tedyapo/sampling-scope-WIP/README.md

# sampling-scope-WIP
Work towards an open-source multi-GHz sampling oscilloscope design

Board designs are in Eagle. They are 4-layer, so require a subscription license to edit (I believe).

NB: as titled, this project is very much a work-in-progress. Completed designs will be published elsewhere.
