tedyapo/sampling-scope-WIP/proto2/README.md

# proto2

This version incorporates the timebase calibration loop.

It has not been fully tested yet.

This version will be abandoned, as it was never entended as a final product, just as a testbed for an evolving design.
