tedyapo/sampling-scope-WIP/timebase-cal-proto/README.md

# timebase-calibrator

This design is a simple test of the timebase calibration loop.

It does not function as an oscilloscope, simply serving to test calibration strategies for the SY89296U-based timebase.
