tedyapo/sampling-scope-WIP/(threads)

Thread 1 (2019-12-12):

pdf schemetic output of proto 2 is not readable

odinthenerd, 2019-12-12:
https://github.com/tedyapo/sampling-scope-WIP/blob/master/proto2/proto2-schematic.pdf this looks like the pdf printer was not called with the right params

tedyapo, 2019-12-13:
good catch; thanks; updated

Closed 2019-12-13.
