tedyapo/sampling-scope-WIP/proto2/proto2-schematic.pdf

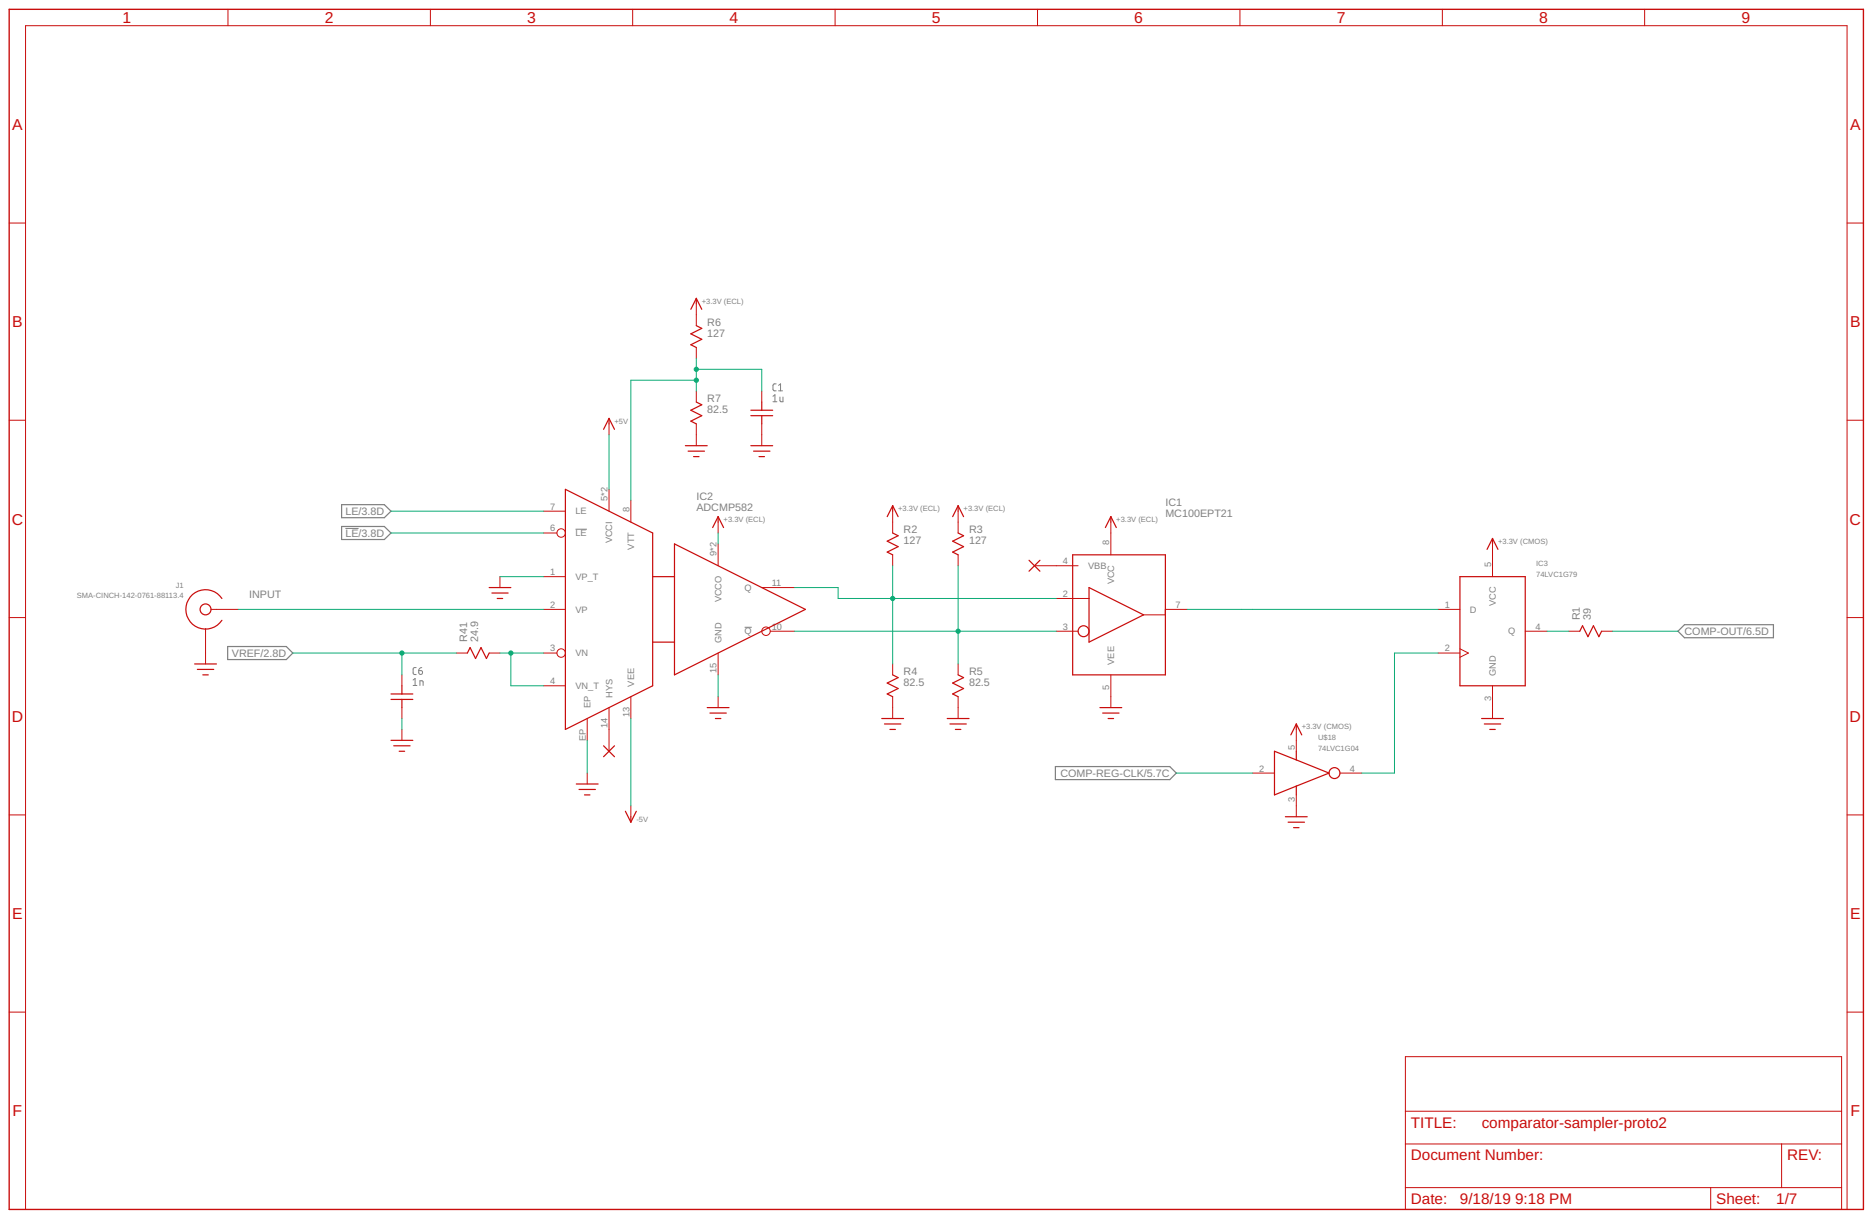
[picture p1: page 1]

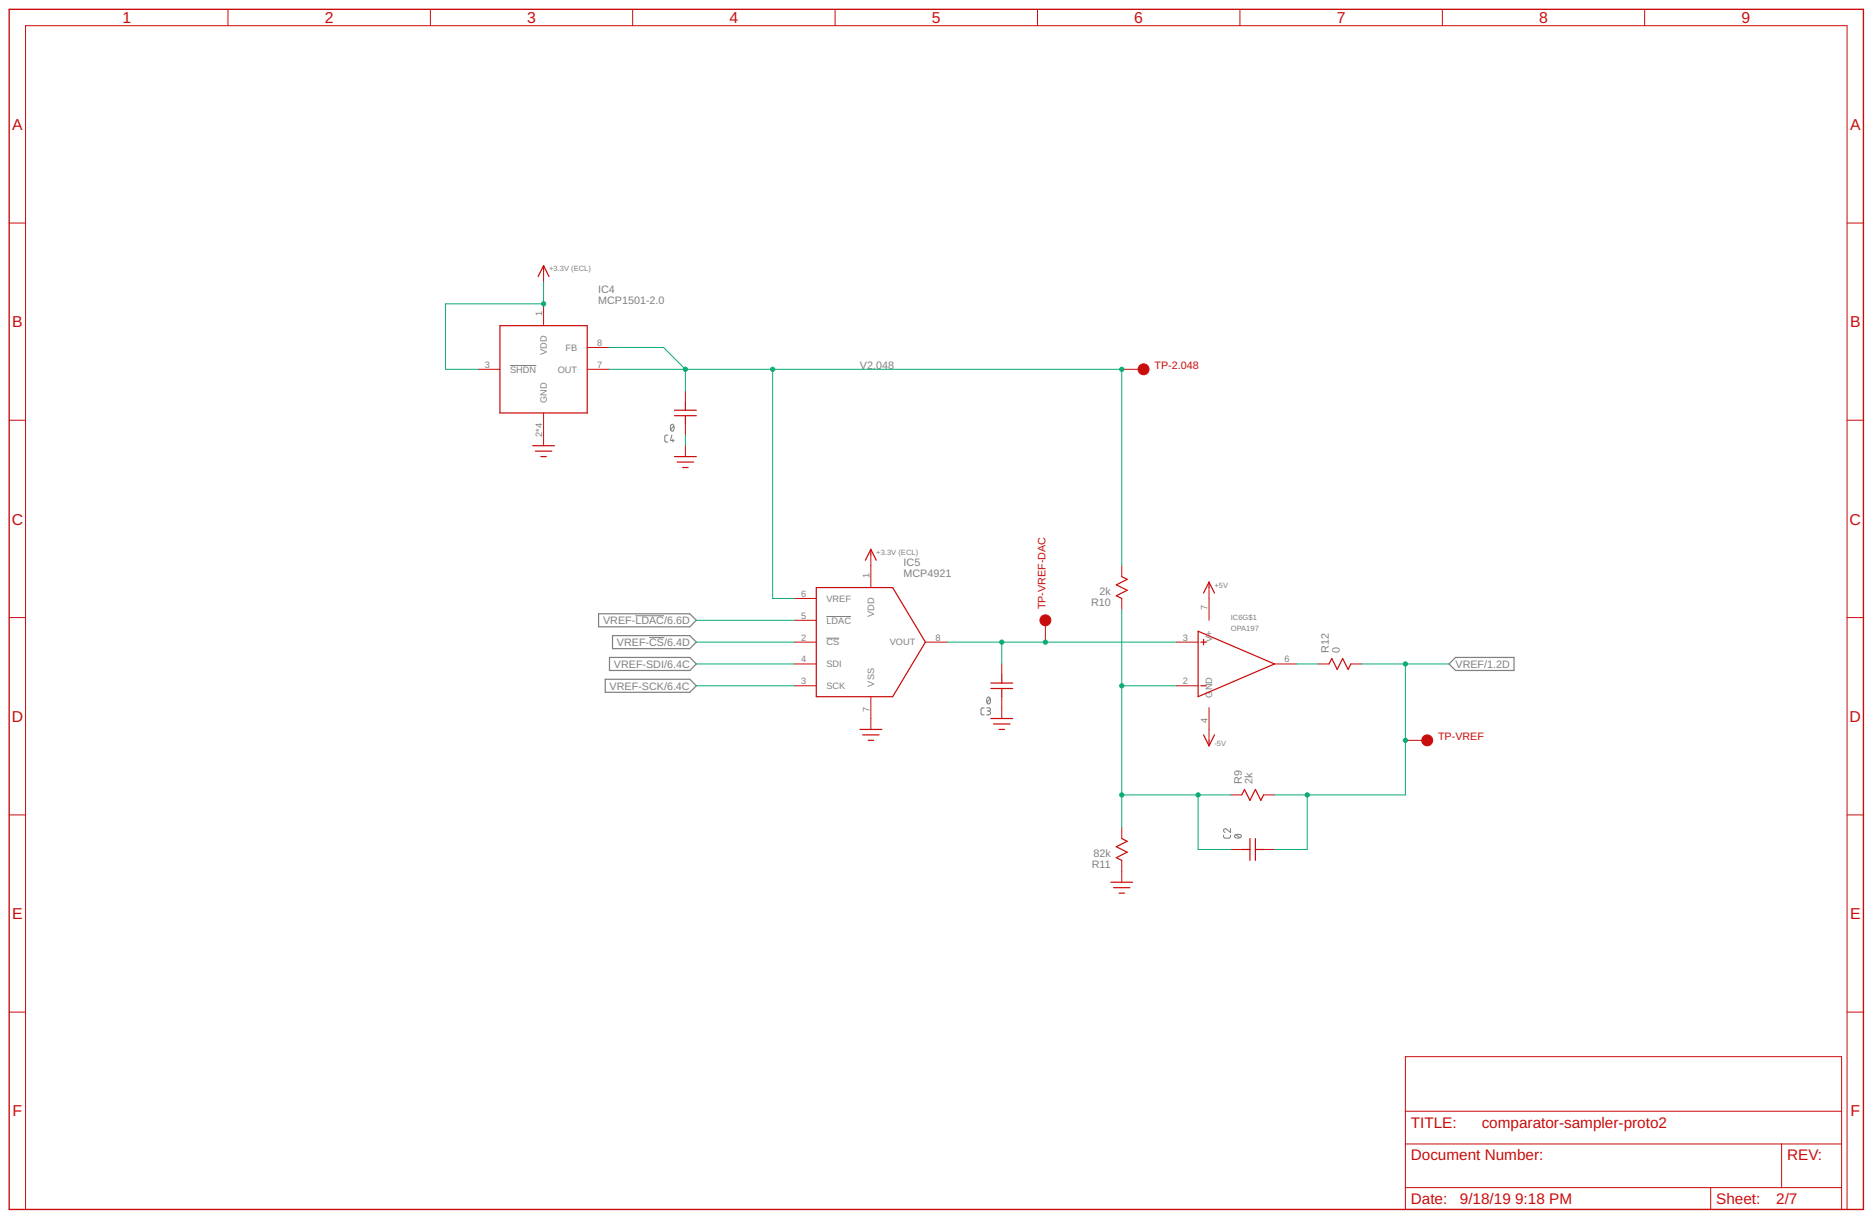
[picture p2: page 2]

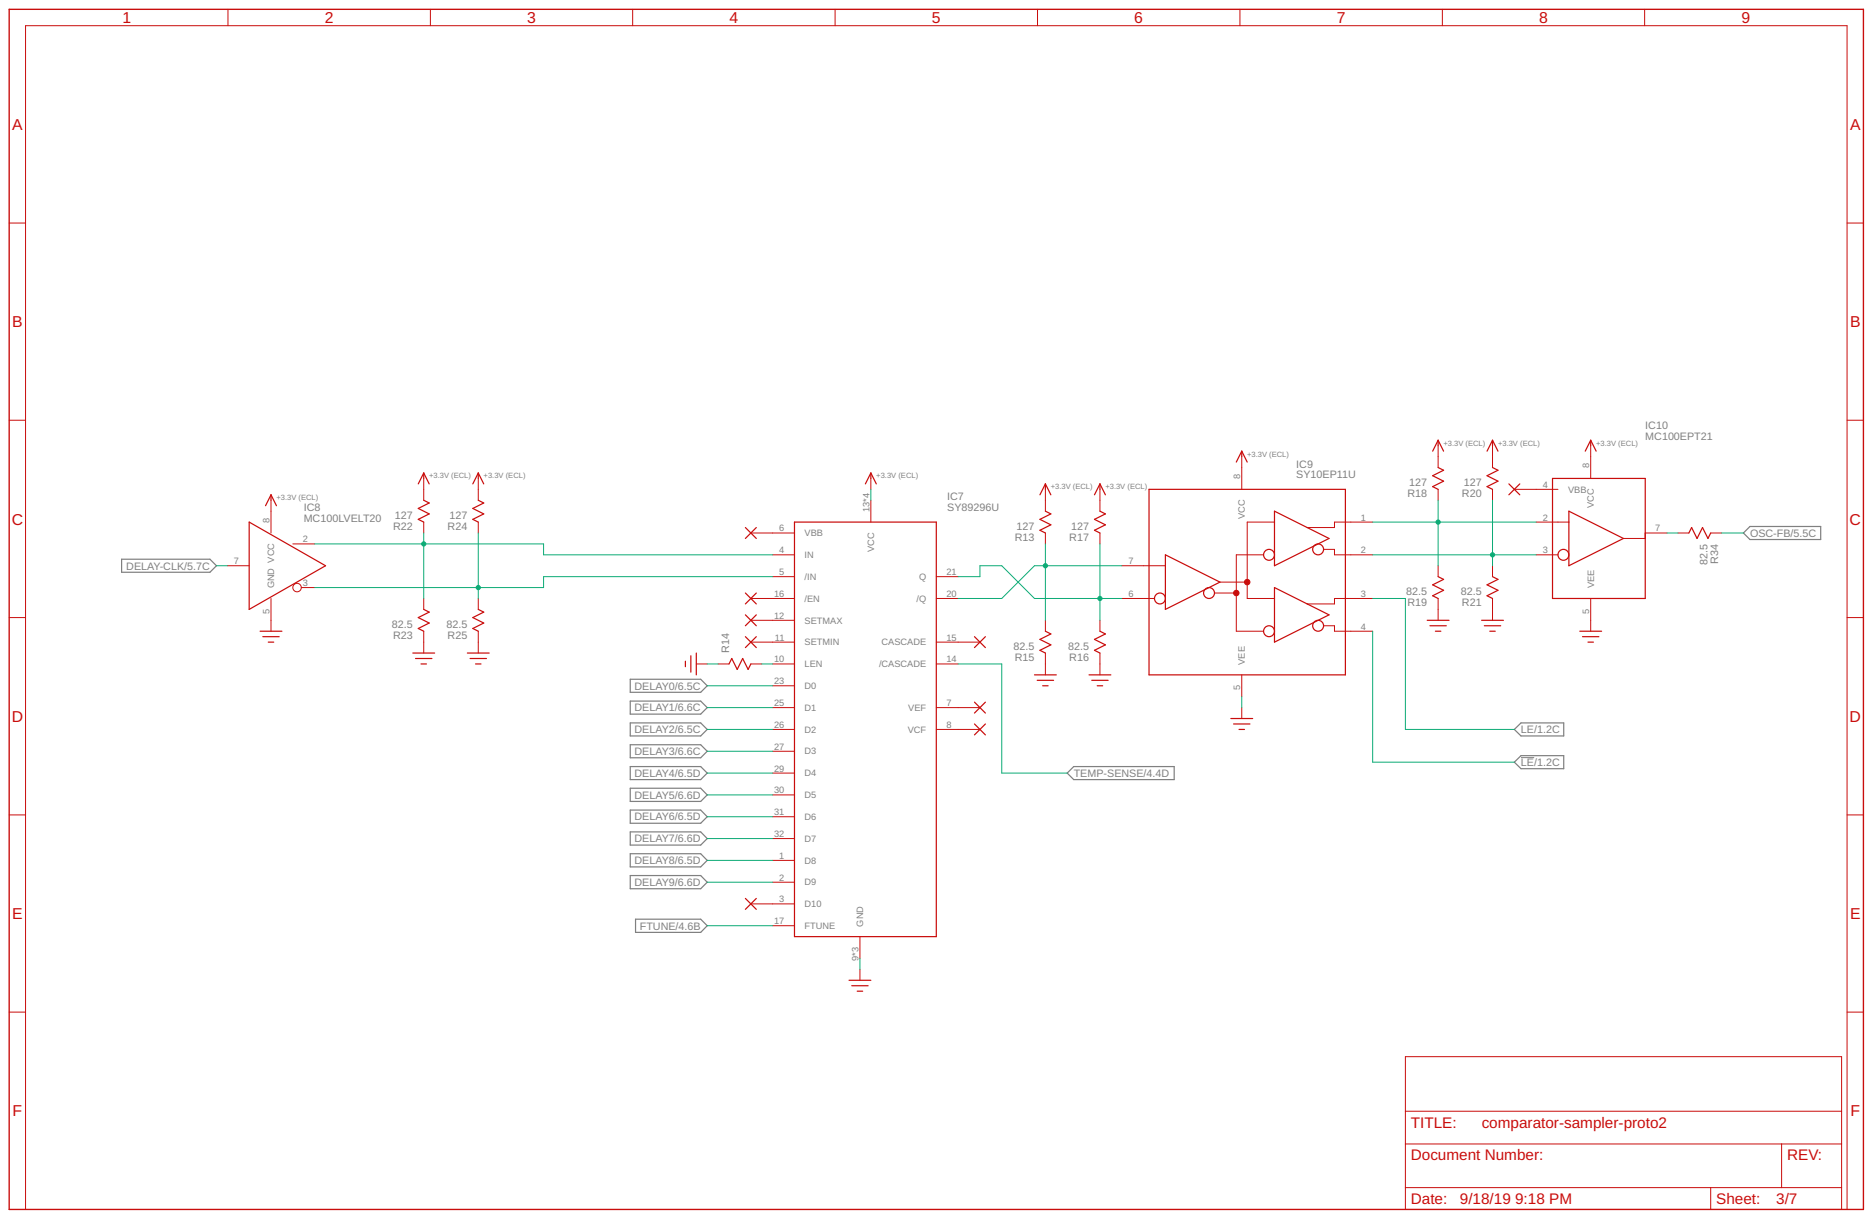
[picture p3: page 3]

7 VCC

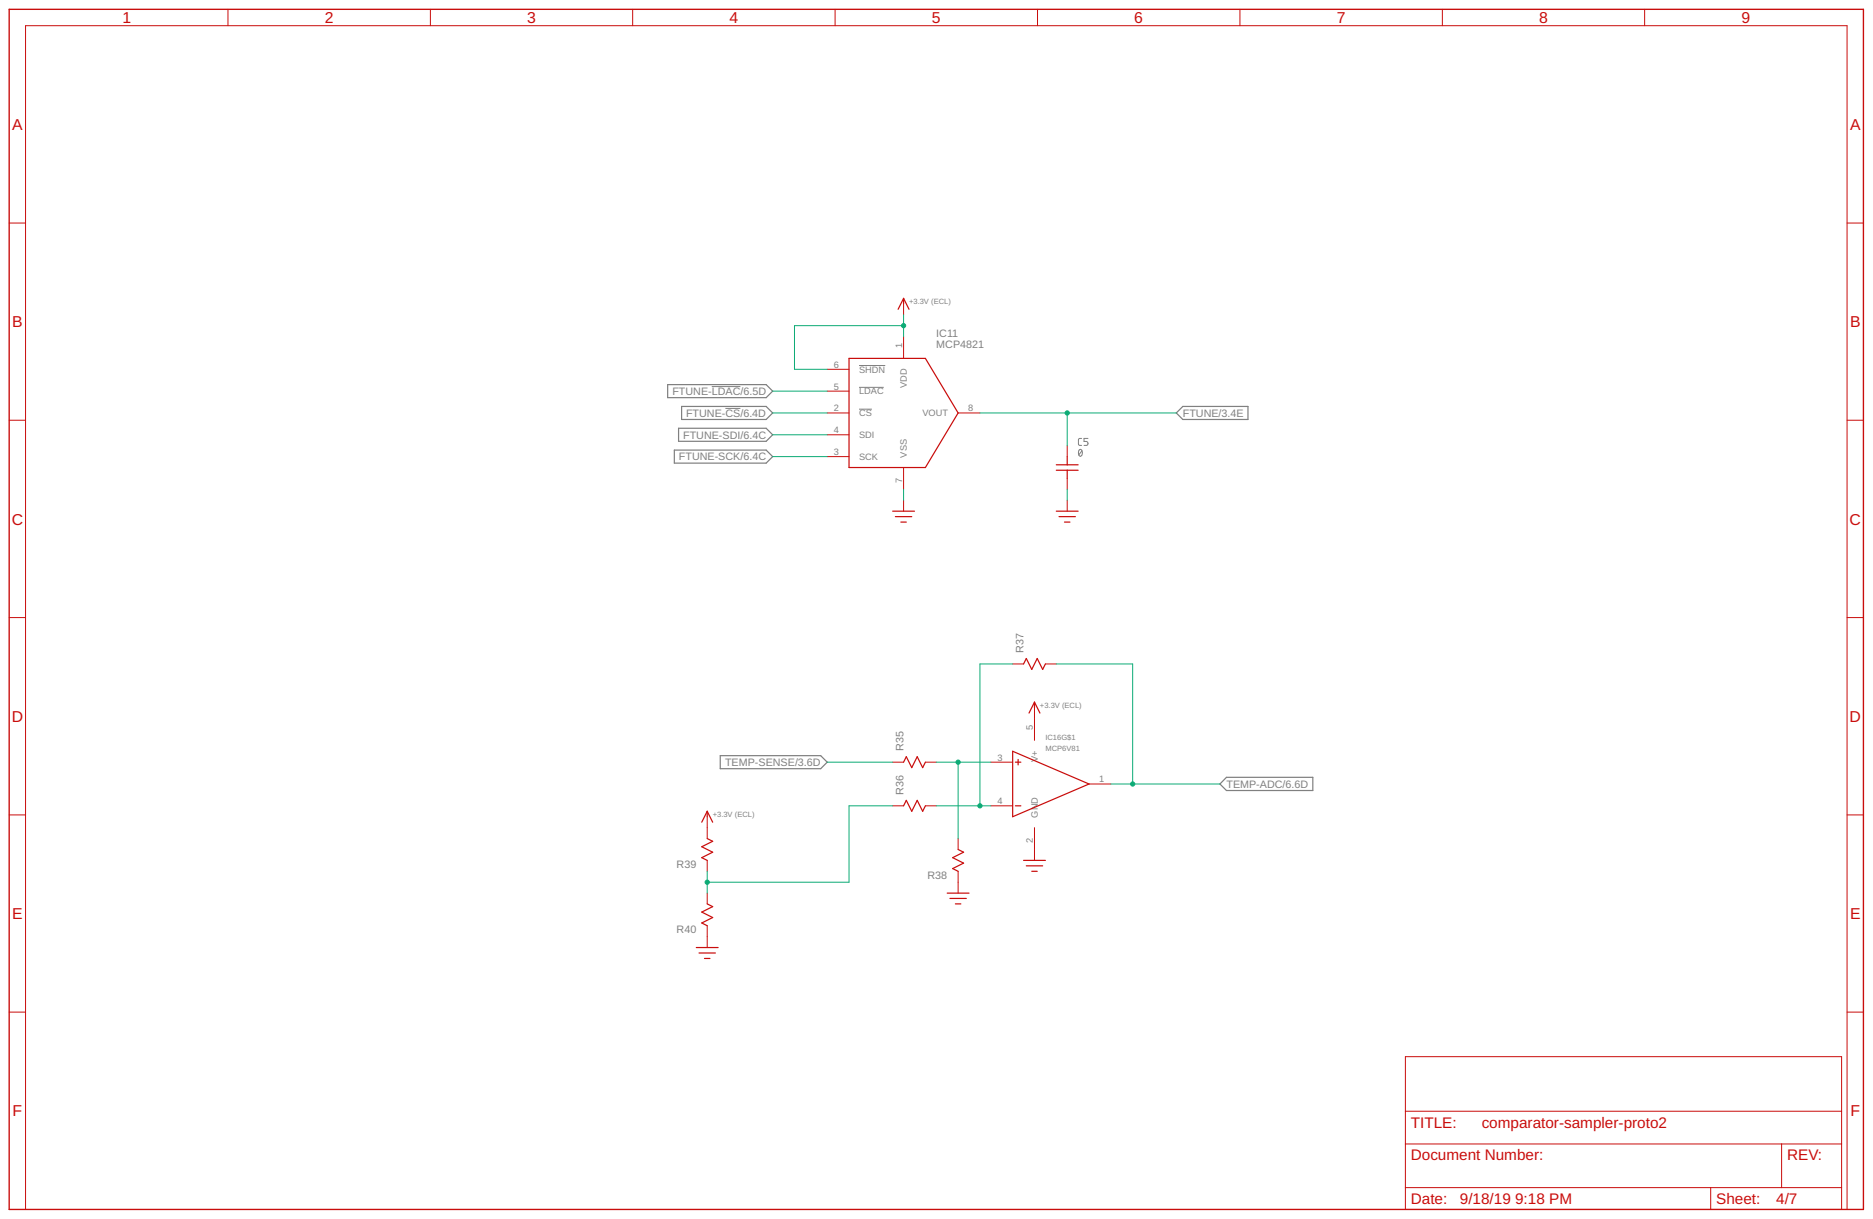
[picture p4: page 4]

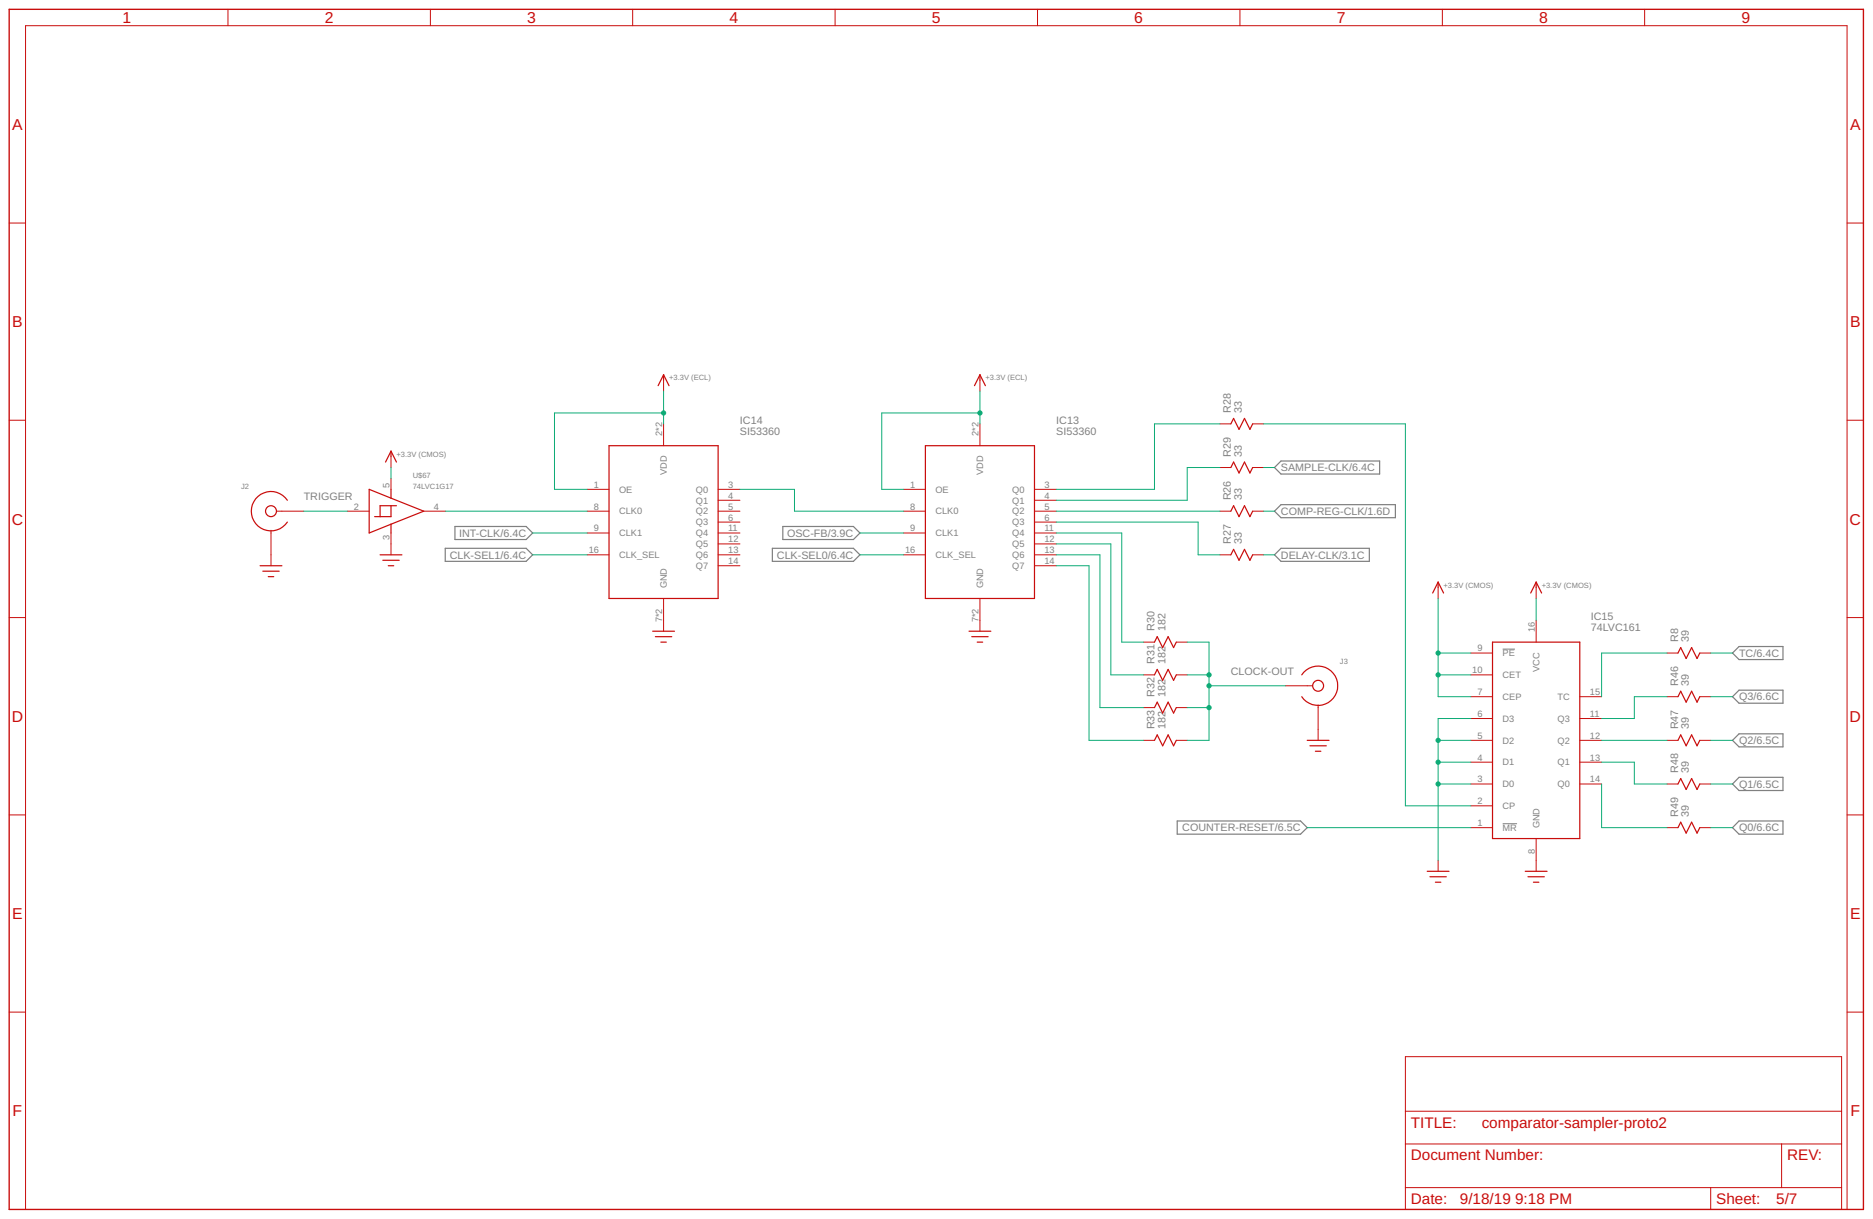
[picture p5: page 5]

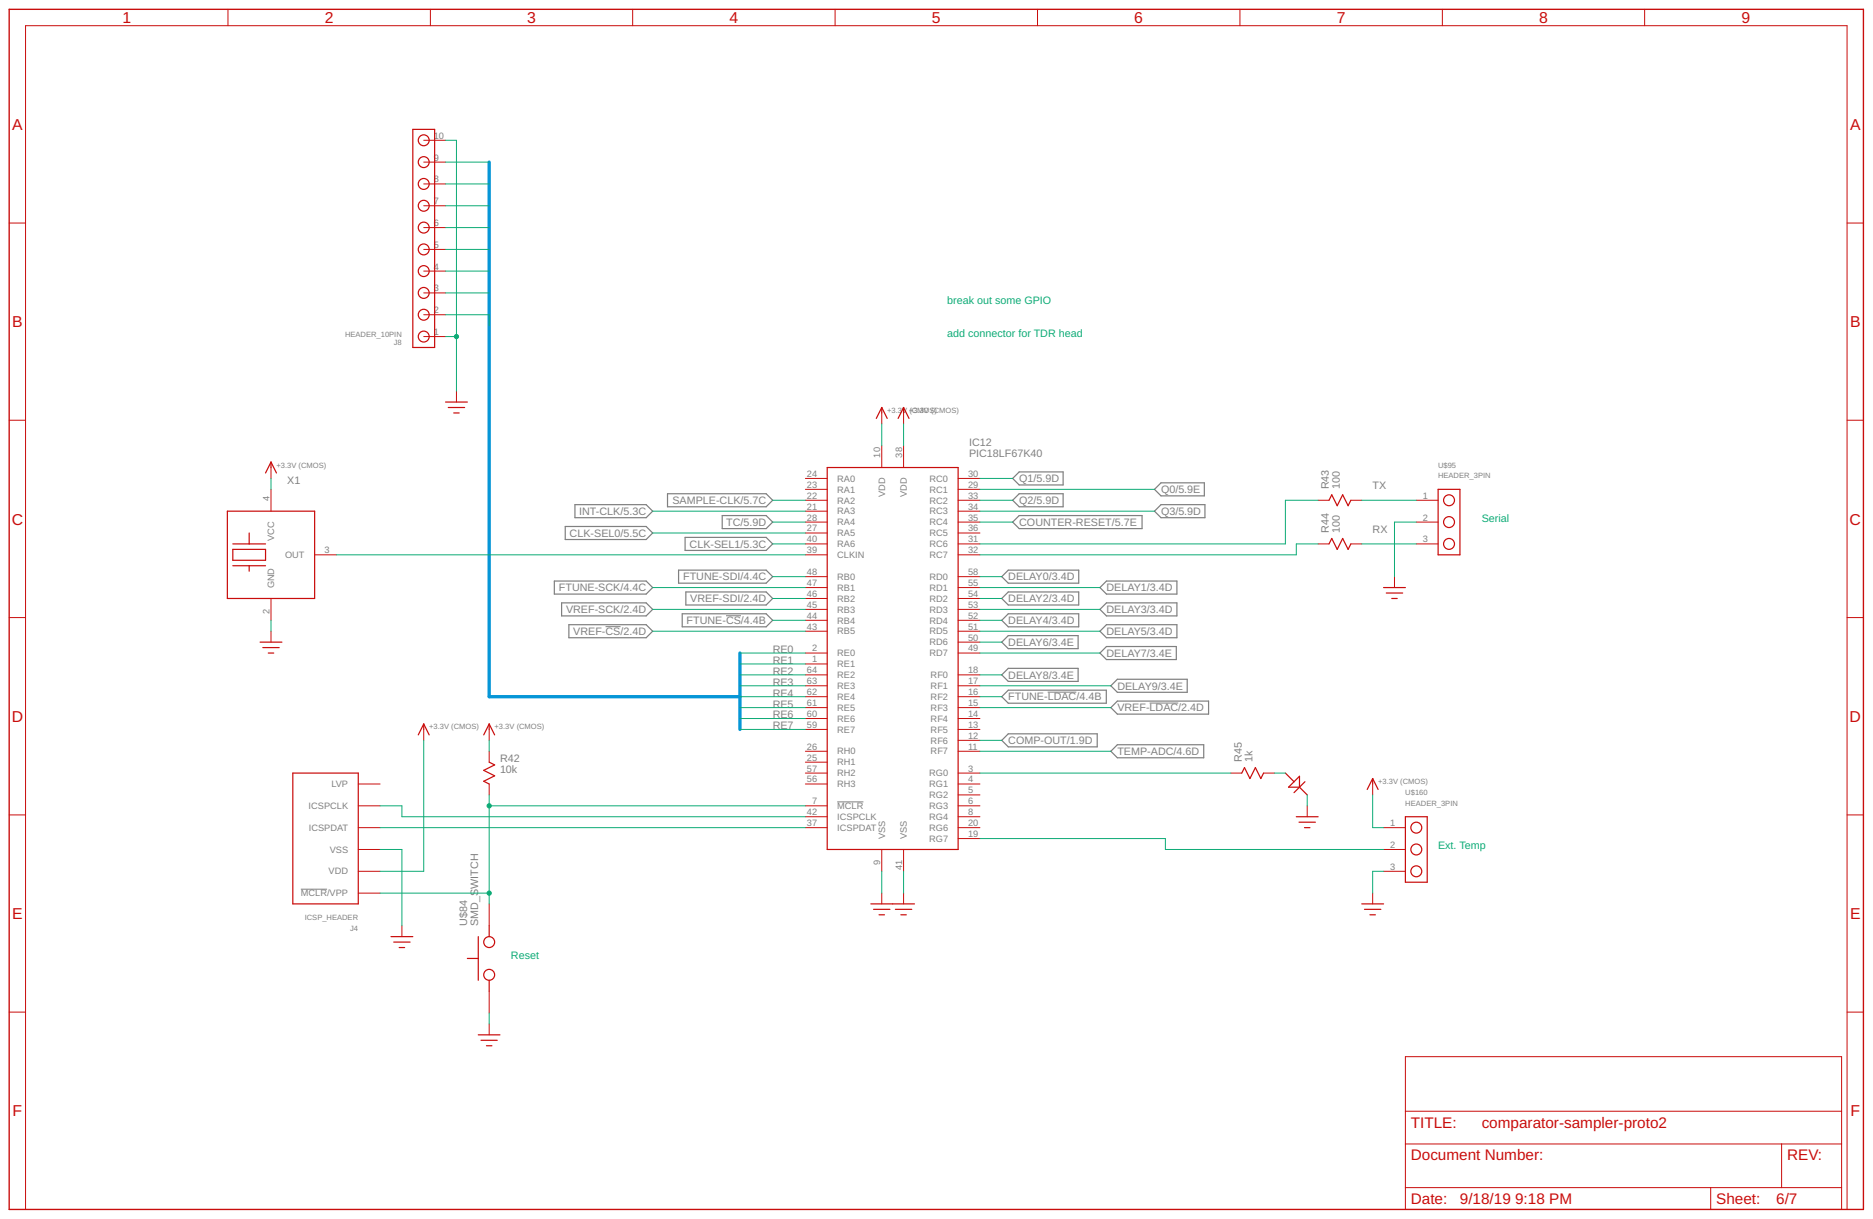
[picture p6: page 6]

break out some GPIO

add connector for TDR head

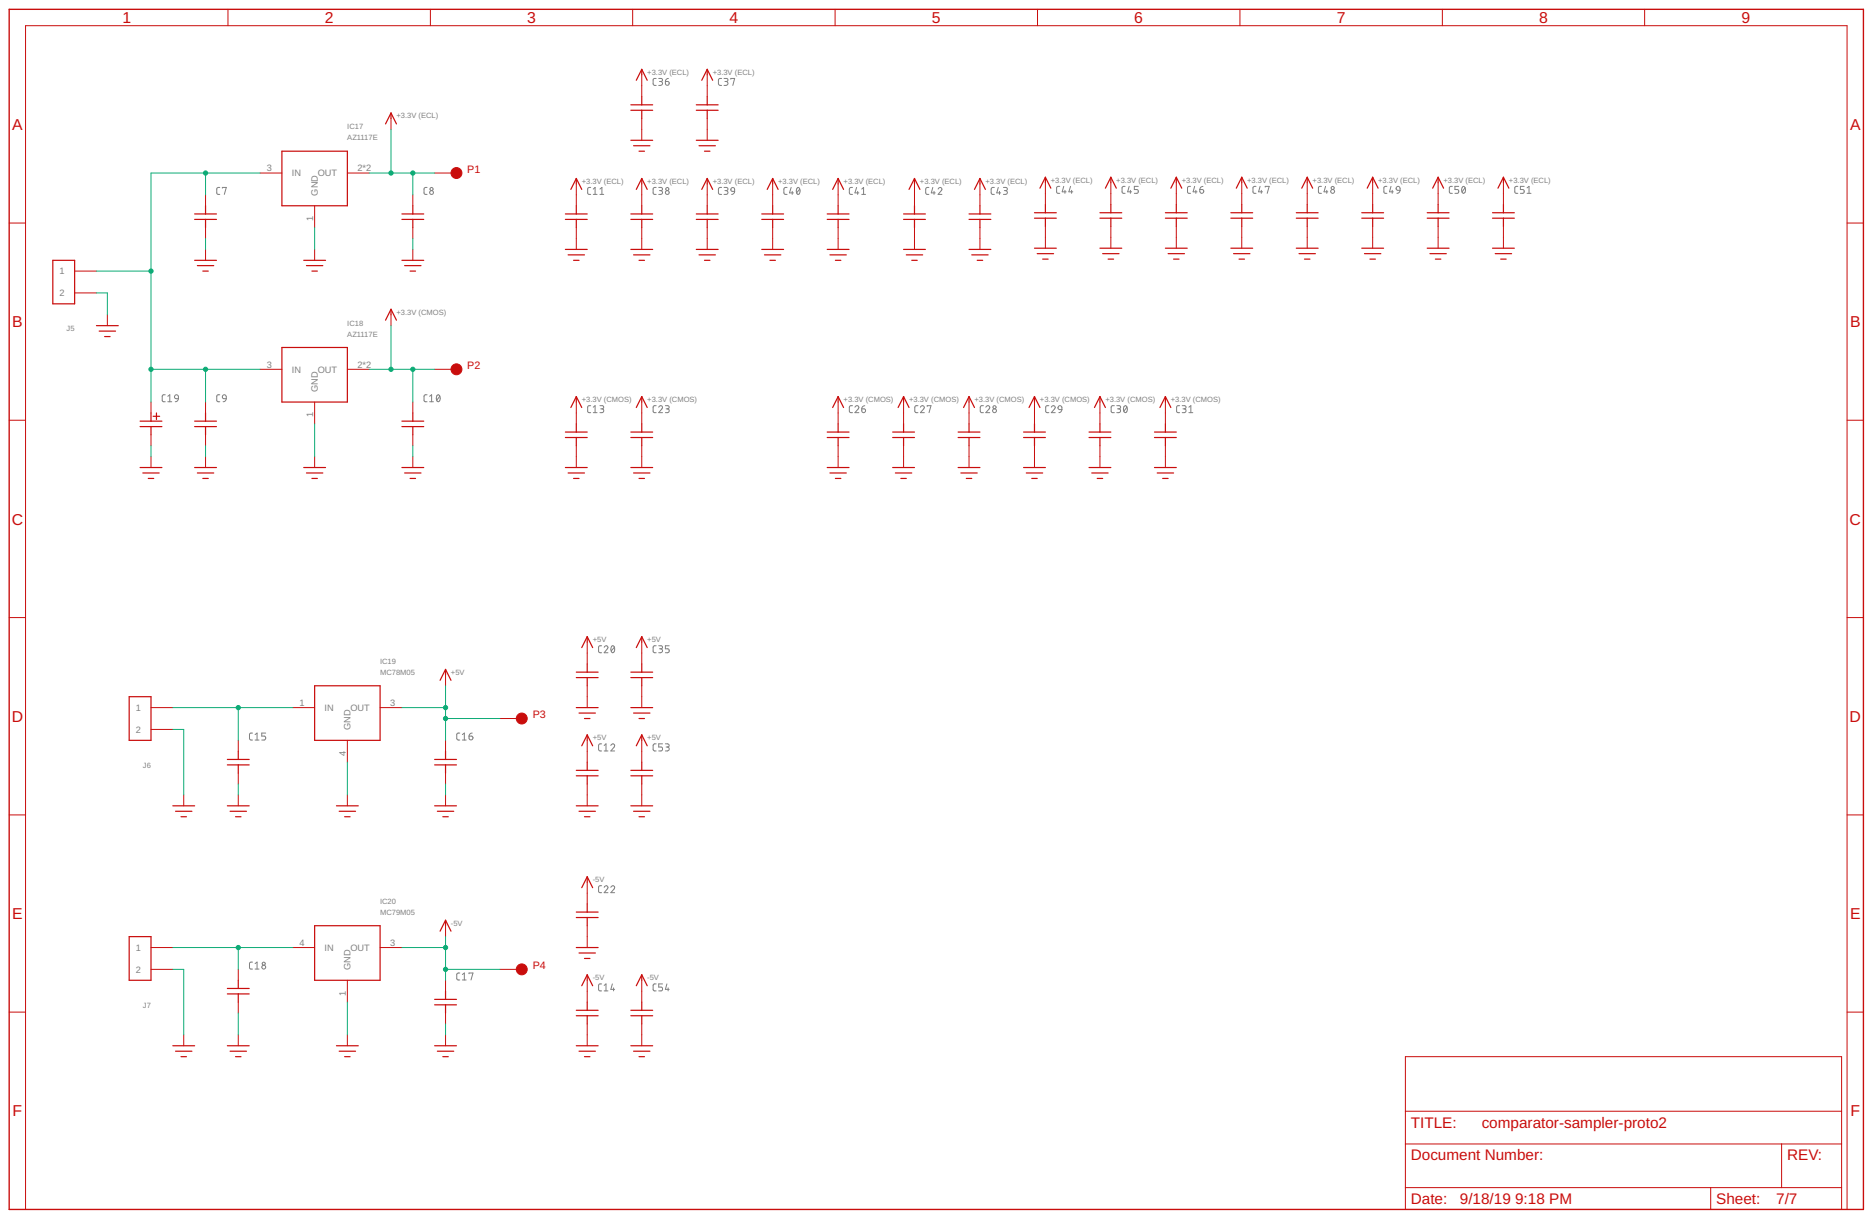
[picture p7: page 7]
