tedyapo/sampling-scope-WIP/proto1/proto1-layout.pdf

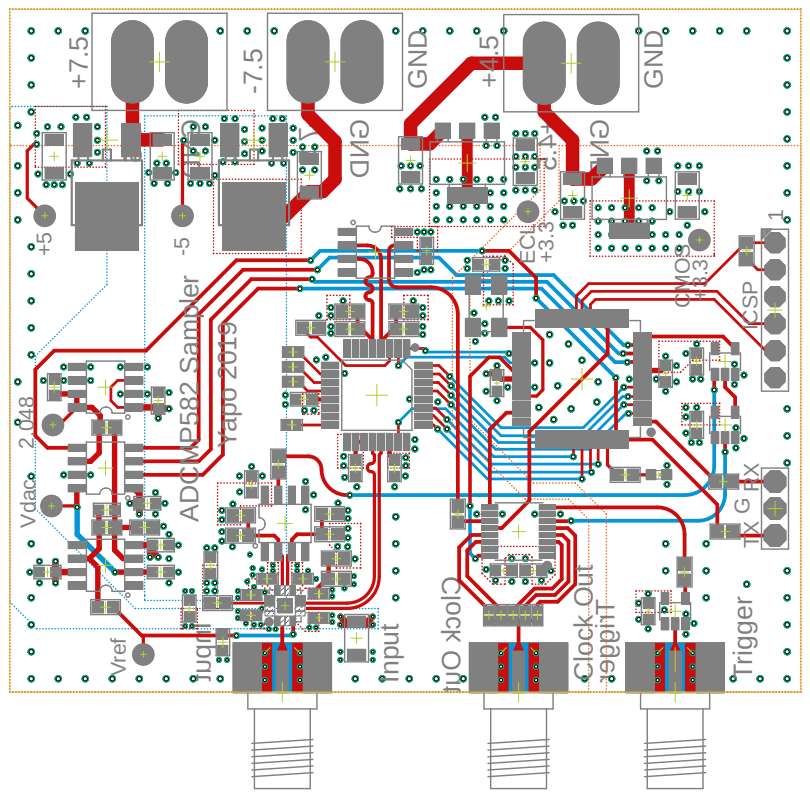
[picture p8: page 1]

+7.5 GND -7.5 GND +4.5 GND Input Clock Out Trigger +7.5 -7.5 +4.5 GND GND Input Trigger Clock Out Vref Vdac +5-5+3.3 +3.3 2.048 RX TX G ICSP 1 ADCMP582 Sampler Yapo 2019 ECL CMOS
