tedyapo/sampling-scope-WIP/proto1/proto1-schematic.pdf

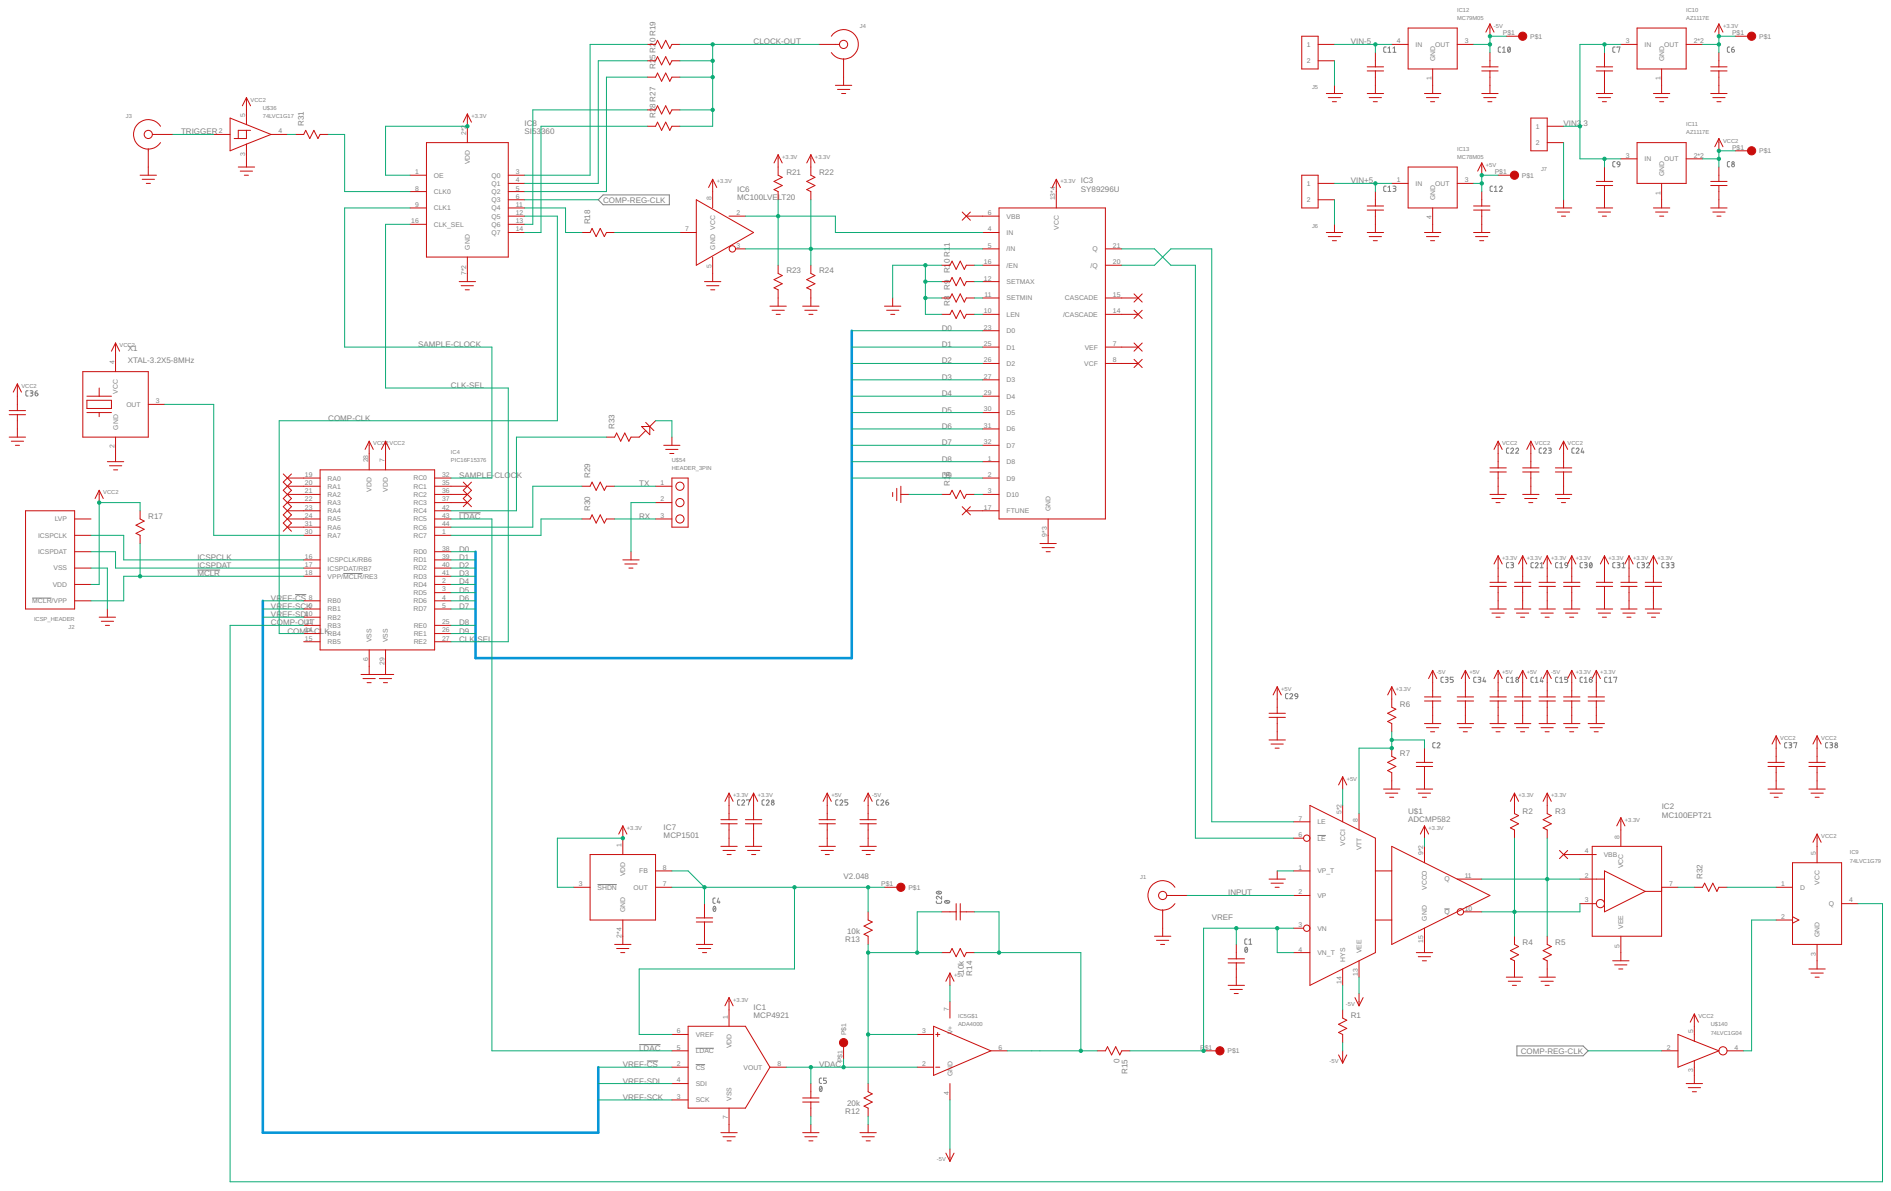
[picture p9: page 1]

ICSPDAT MCLR | 17 | | 39 RD2 40 RD3 D2

COMP-OUT
