tedyapo/sampling-scope-WIP/timebase-cal-proto/calibrator-test-layout.pdf

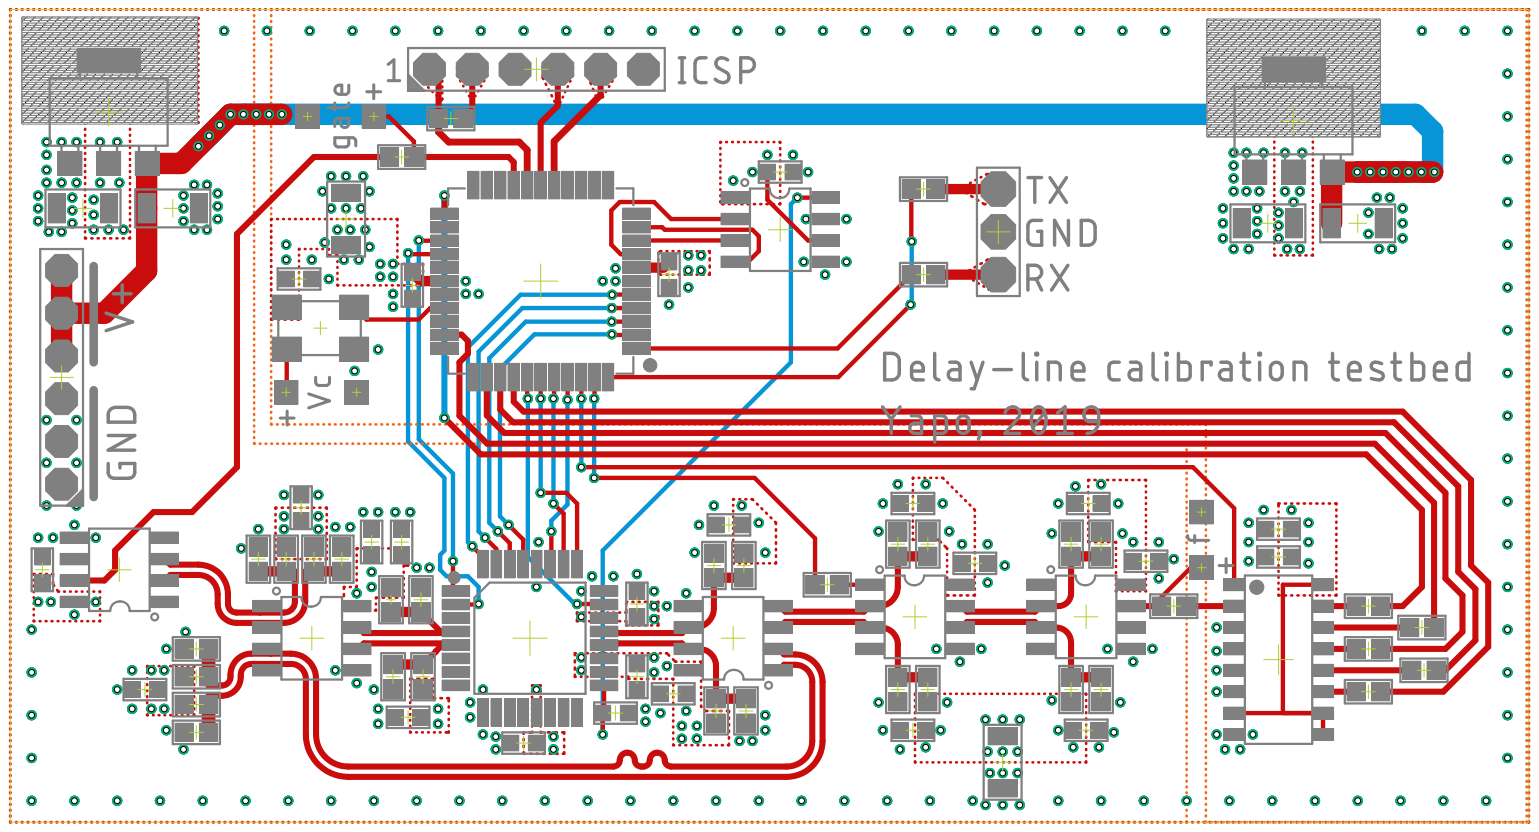
[picture p10: page 1]
