tedyapo/sampling-scope-WIP/timebase-cal-proto/calibrator-test-schematic.pdf

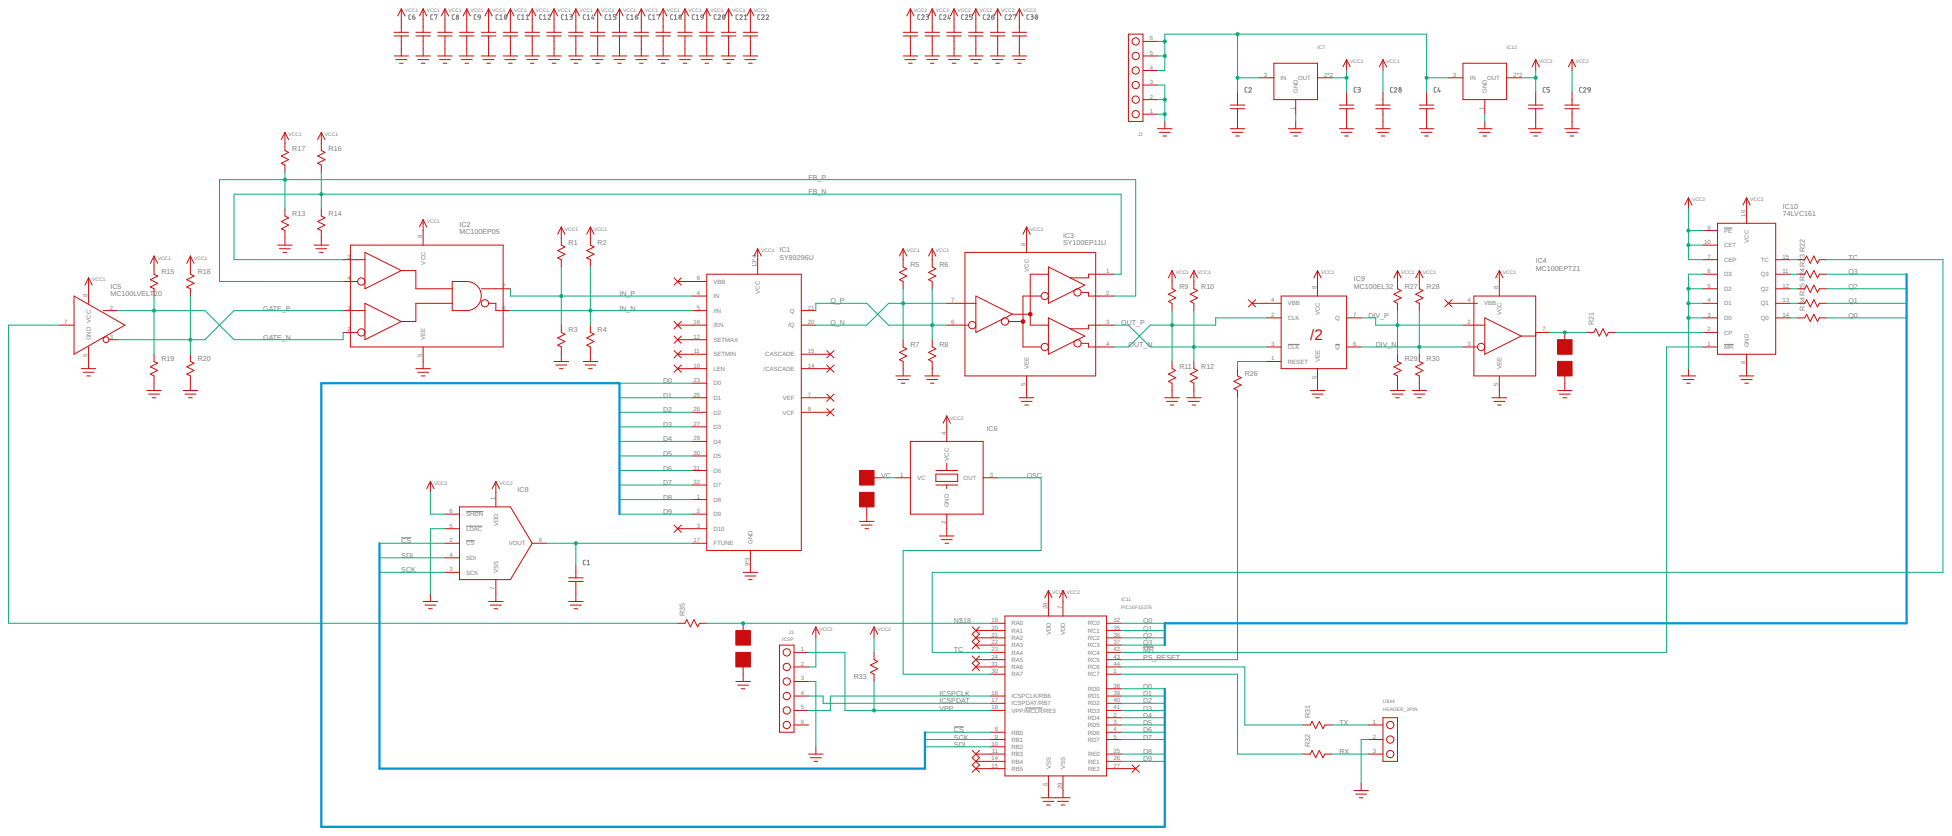
[picture p11: page 1]
