tedyapo/sampling-scope-WIP/proto2/proto2-layout.pdf

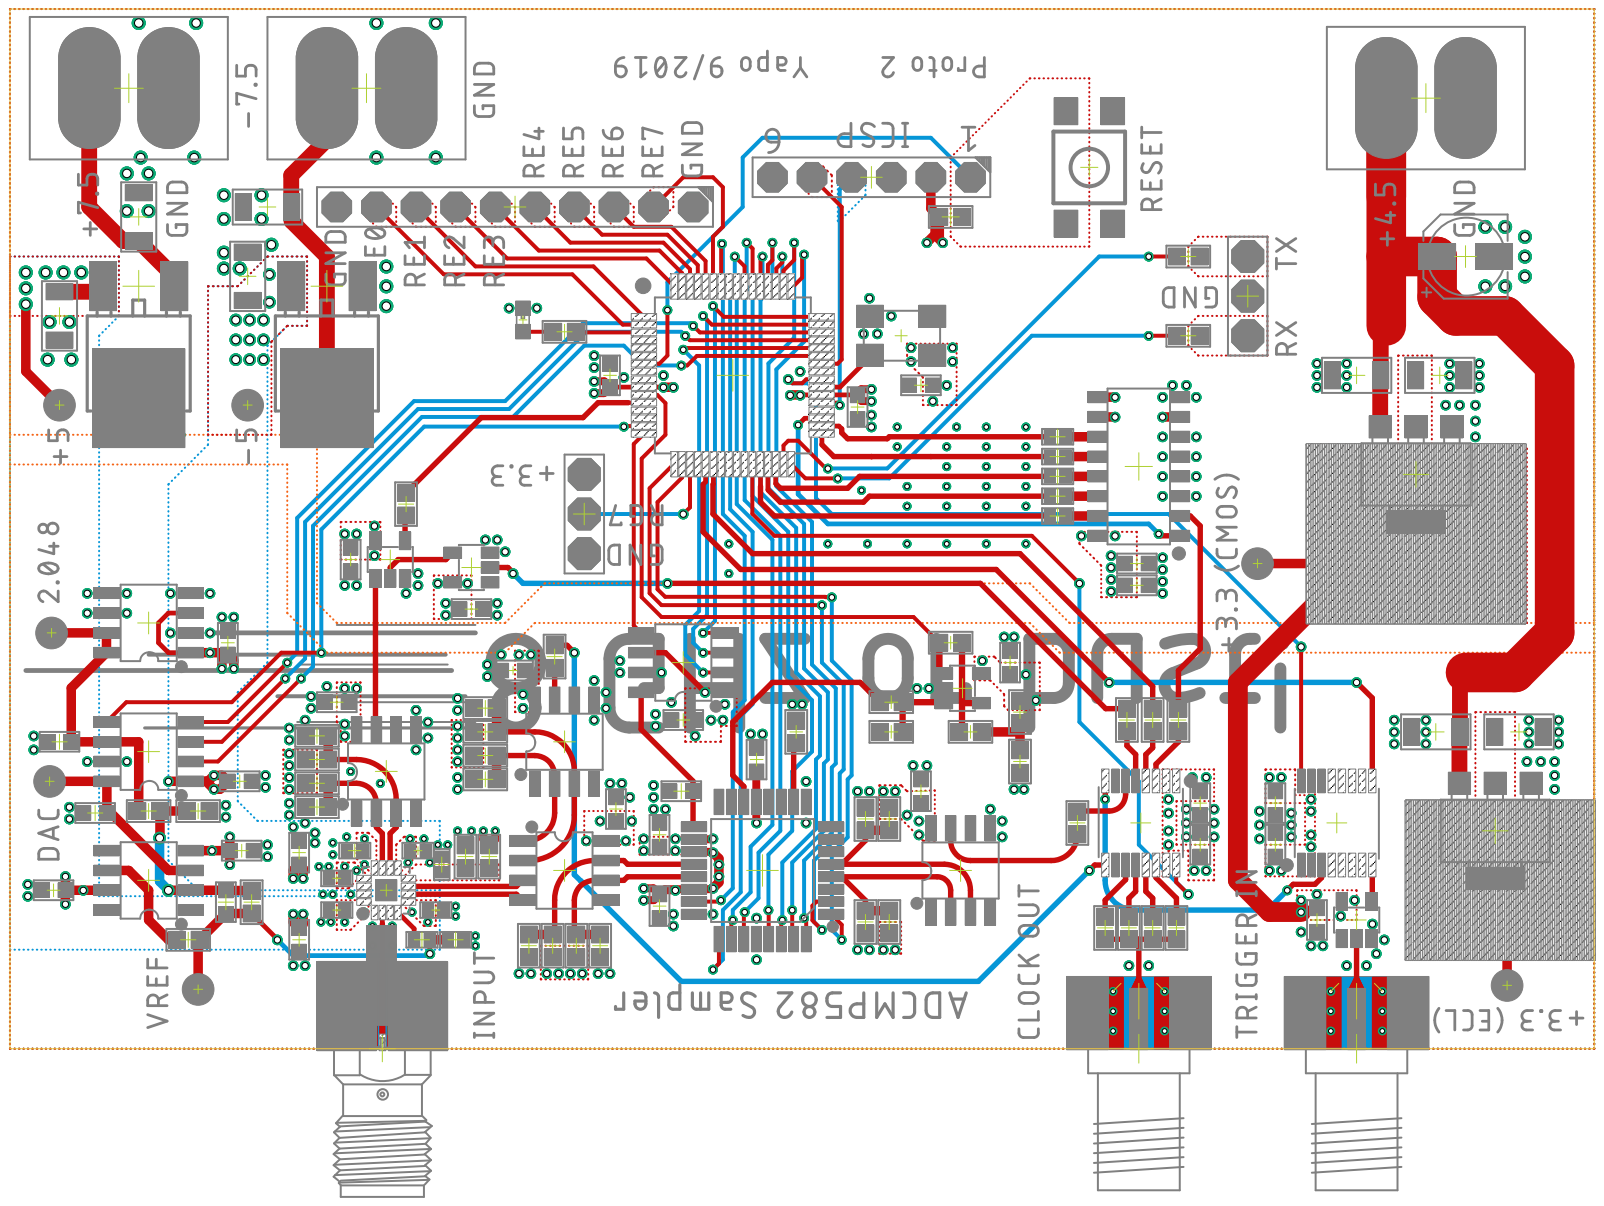
[picture p12: page 1]
