tedyapo/sampling-scope-WIP/proto1/proto1.brd

## EAGLE design proto1/proto1.brd (2019-10-04)

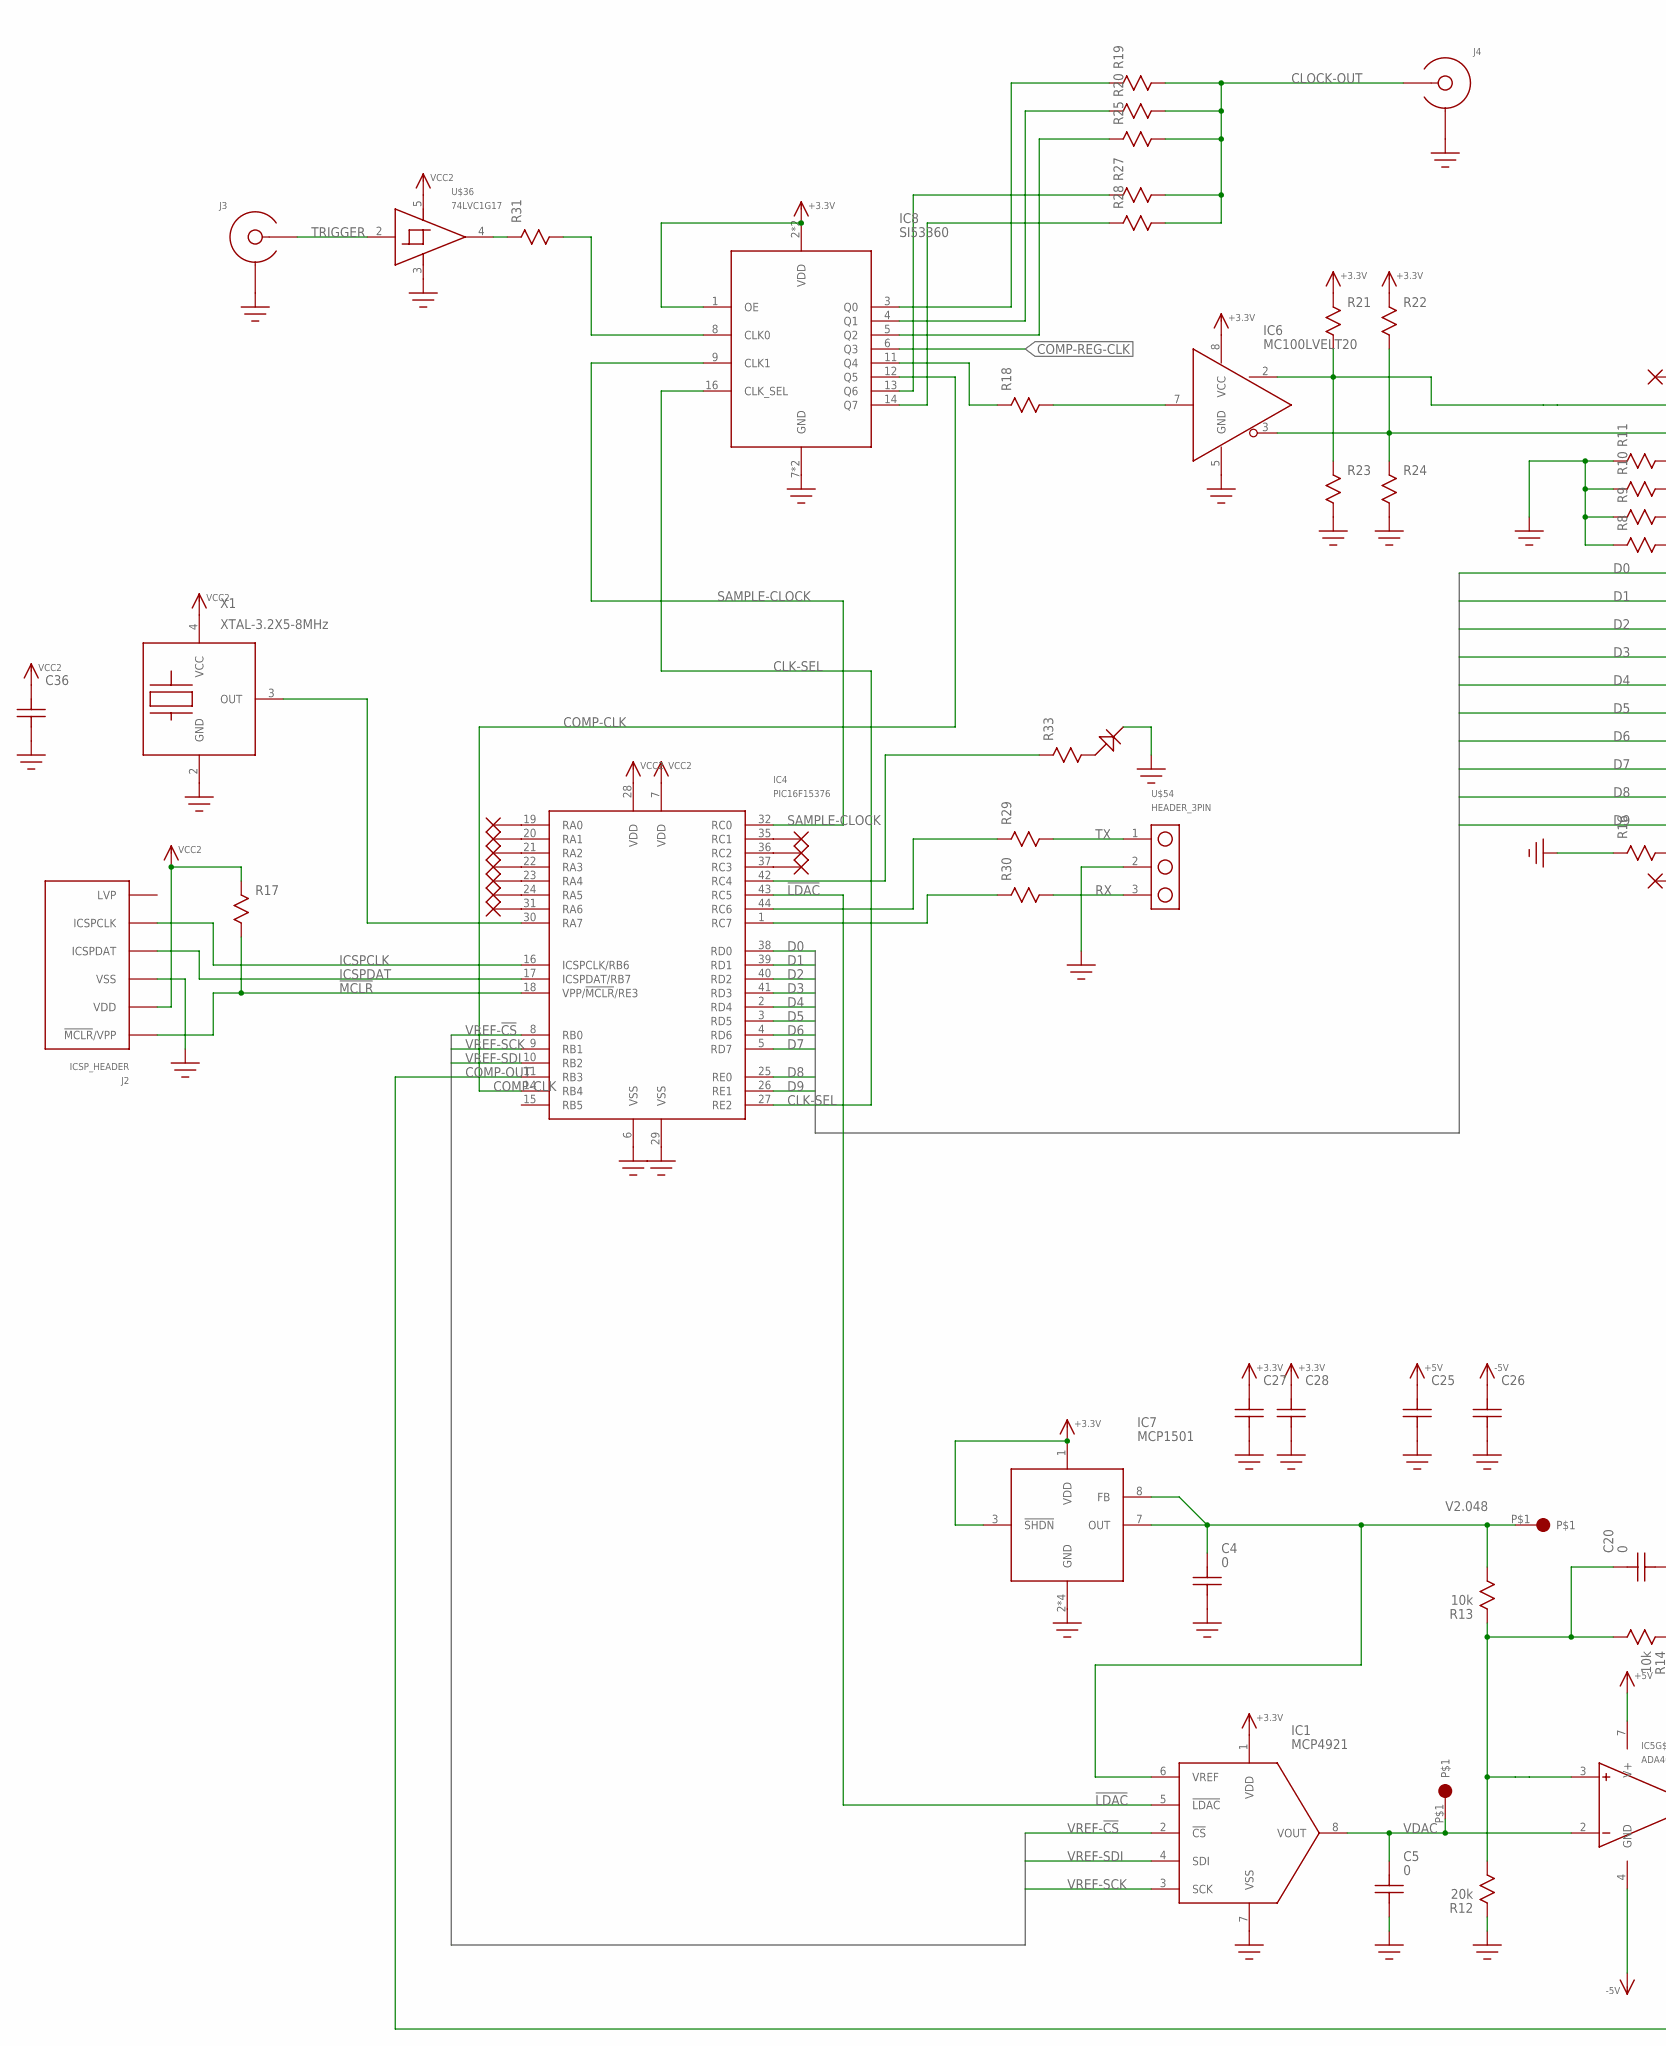
[picture p13: schematic proto1.sch, part in row 1, column 1]

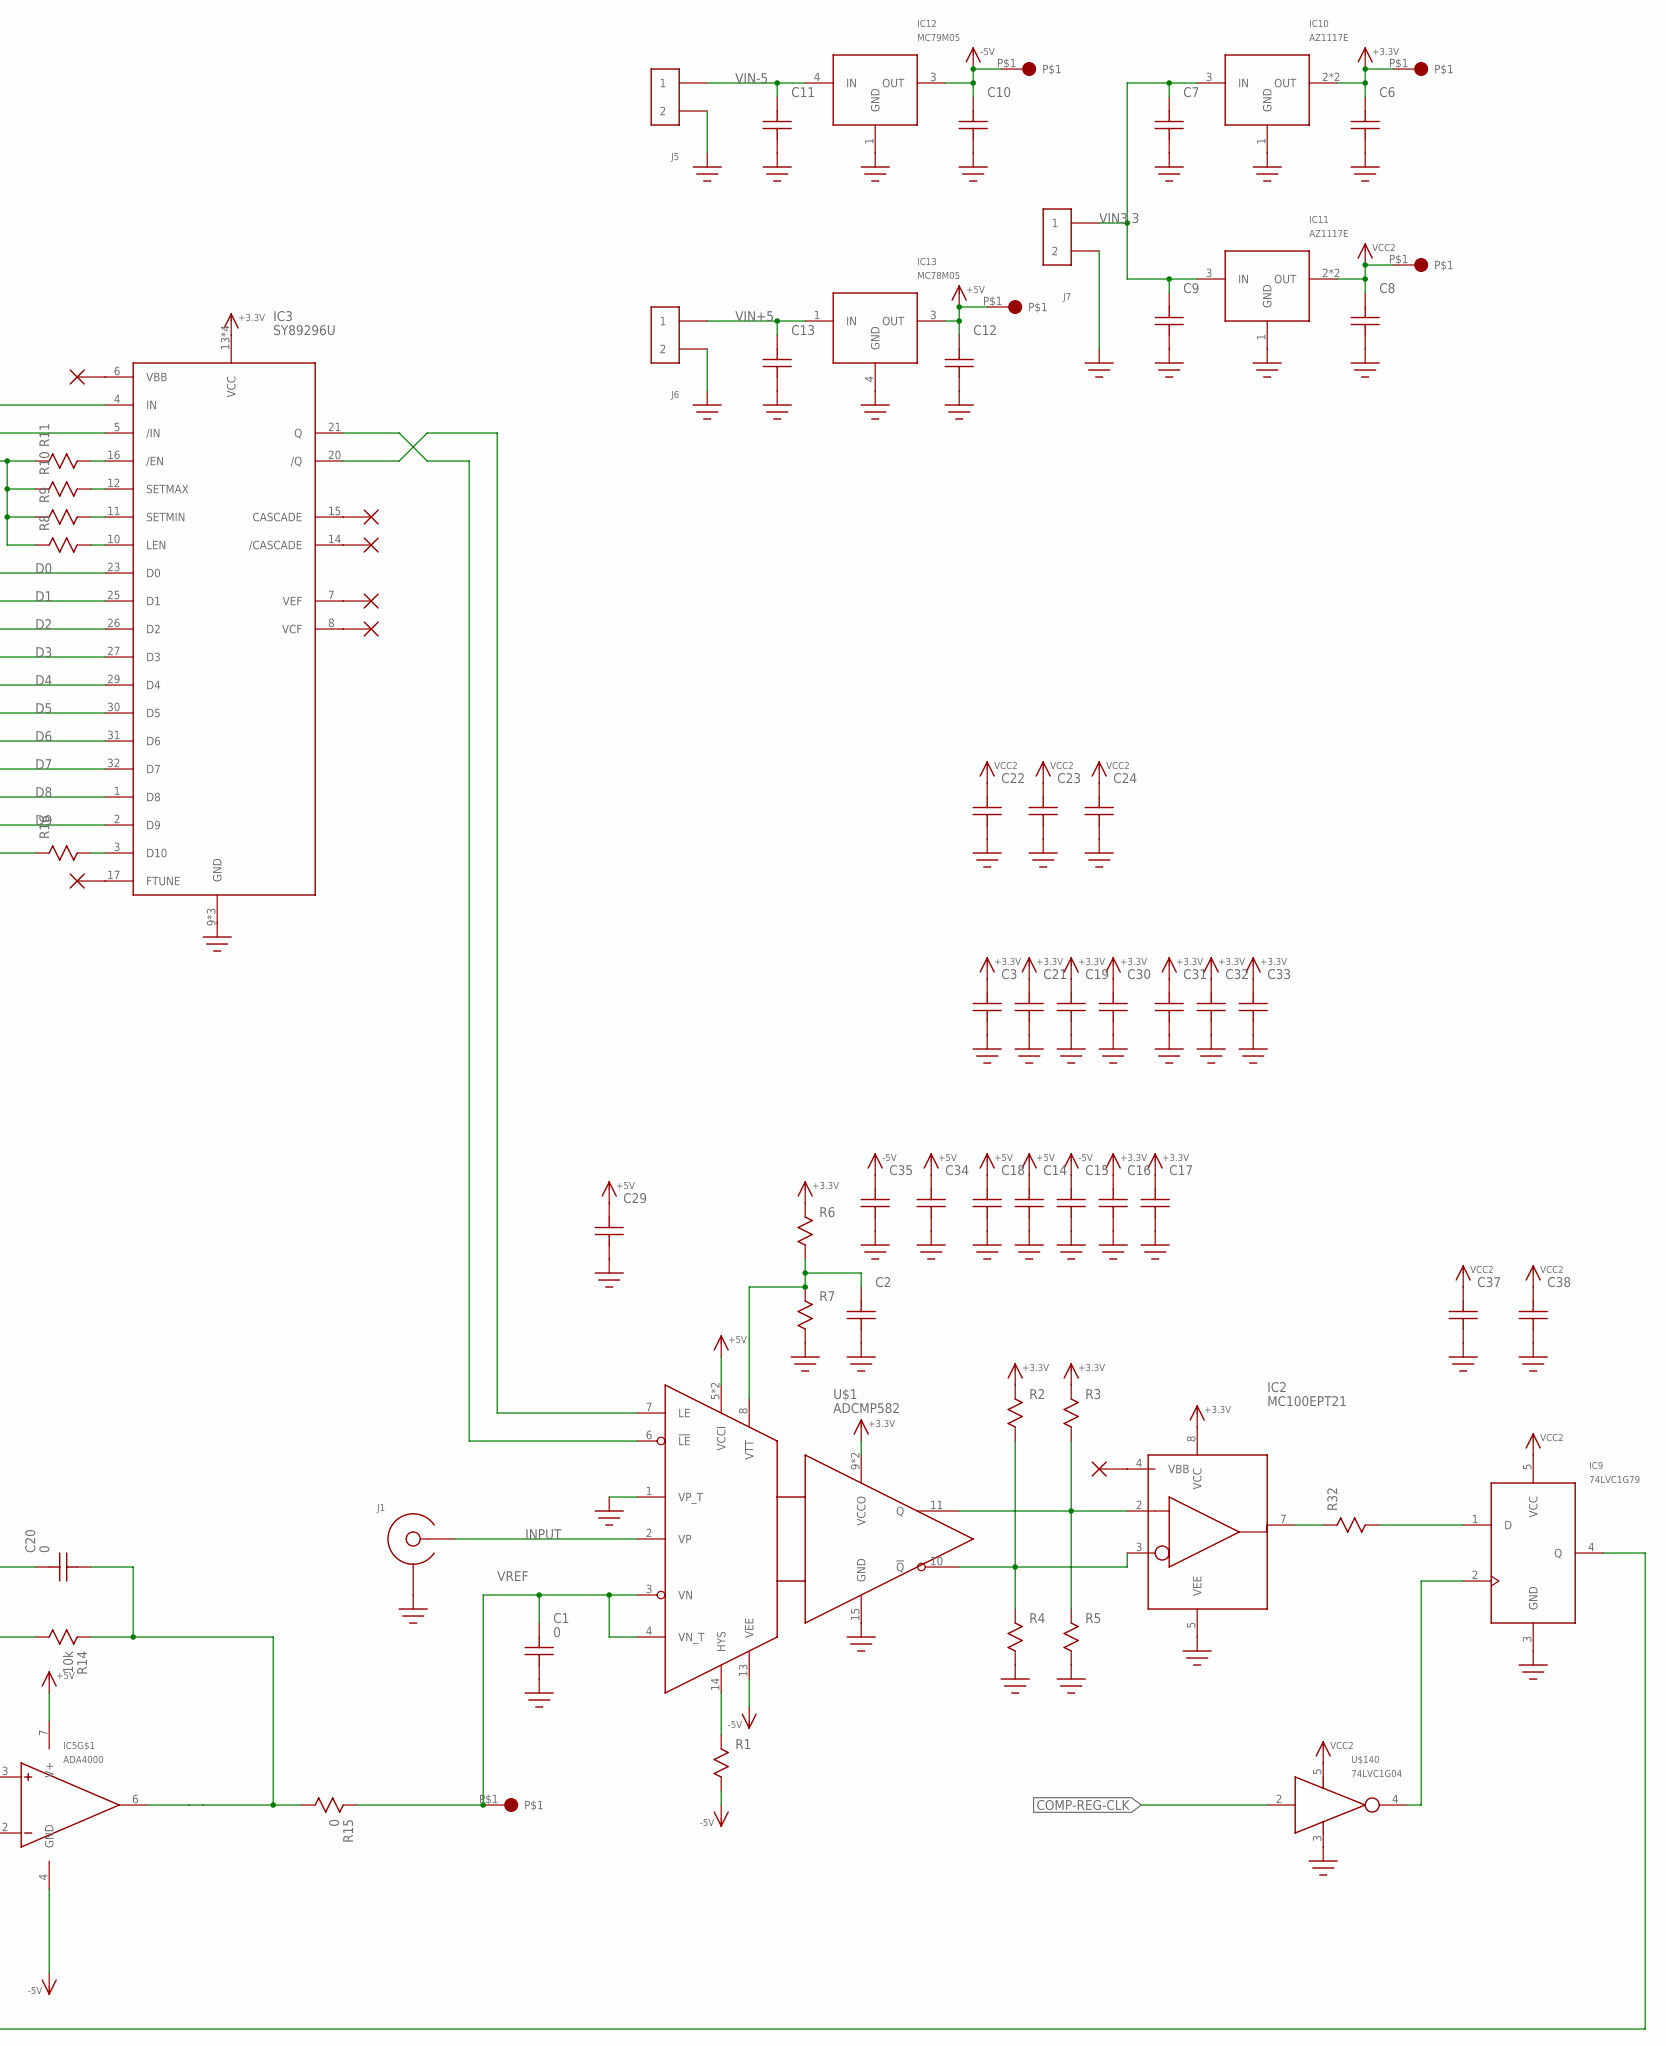
[picture p14: schematic proto1.sch, part in row 1, column 2]

Parts:
C1, C4, C5, C20: 0; C0603
C2, C14, C15, C16, C17, C18: C0402_NO_THERMALS
C3, C19, C21, C22, C23, C24, C25, C26, C27, C28, C30, C31, C32, C33, C34, C35, C36, C37, C38: C0603
C6, C7, C8, C9, C10, C11, C12, C13, C29: C1206; 1206
IC1: MCP4921; SOIC8
IC2: MC100EPT21; SOIC8
IC3: SY89296U; TQFP32_7X7
IC4: PIC16F15376; TQFP44
IC5: ADA4000; SOIC8
IC6: MC100LVELT20; SOIC8
IC7: MCP1501; SOIC8
IC8: SI53360; TSSOP16
IC9: 74LVC1G79; SOT23-5
IC10, IC11: AZ1117E; SOT-223
IC12: MC79M05; DPAK
IC13: MC78M05; DPAK
J1, J3, J4: SMA-EDGE-LAUNCH4L-4020-TAPER-FIXED; SMA_EDGE_LAUNCH_4L_4020_TAPER_FIXED
J2: ICSP_HEADER; HEADER_6PIN
J5, J6, J7: HEADER_2PINSCREW-TERM; FCI_20020316_SCREW_TERM_2P
P1, P2, P3, P4, P5, P6, P7: ICSP_PAD
R1, R2, R3, R4, R5, R6, R7, R16, R17, R18, R21, R22, R23, R24, R29, R30, R31, R32, R33: R0603
R8, R9, R10, R11, R19, R20, R25, R27, R28: R0402; 0402
R12: 20k; R0603
R13, R14: 10k; R0603
R15: 0; R0603
U$1: ADCMP582; TQFN16-EP
U$36: 74LVC1G17; SOT23-5
U$54: HEADER_3PIN
U$88: LED_0603
U$140: 74LVC1G04; SOT23-5
X1: XTAL-3.2X5-8MHz; XTAL_3.2X5

Connections:
!LDAC!: IC1.5 (!LDAC!), IC4.43 (RC5)
!MCLR!: IC4.18 (VPP/!MCLR!/RE3), J2.1 (!MCLR!/VPP), R17.P$2
+3.3V: C3.P$2, C6.P$2, C16.2, C17.2, C19.P$2, C21.P$2, C27.P$2, C28.P$2, C30.P$2, C31.P$2, C32.P$2, C33.P$2, IC1.1 (VDD), IC2.8 (VCC), IC3.13 (VCC), IC3.18 (VCC), IC3.19 (VCC), IC3.22 (VCC), IC6.8 (VCC), IC7.1 (VDD), IC7.3 (!SHDN!), IC8.1 (OE), IC8.2 (VDD), IC8.15 (VDD), IC10.2 (OUT), IC10.4 (OUT), P5.P$1, R2.P$1, R3.P$1, R6.P$1, R21.P$1, R22.P$1, U$1.9 (VCCO), U$1.12 (VCCO)
+5V: C12.P$2, C14.2, C18.2, C25.P$2, C29.P$2, C34.P$2, IC5.7 (V+), IC13.3 (OUT), P4.P$1, U$1.5 (VCCI), U$1.16 (VCCI)
-5V: C10.P$2, C15.2, C26.P$2, C35.P$2, IC5.4 (GND), IC12.3 (OUT), P3.P$1, R1.P$2, U$1.13 (VEE)
CLK-SEL: IC4.27 (RE2), IC8.16 (CLK_SEL)
CLOCK-OUT: J4.CENTER@1 (CENTER), J4.P$3 (CENTER), R19.2, R20.2, R25.2, R27.2, R28.2
COMP-CLK: IC4.14 (RB4), IC8.12 (Q5)
COMP-OUT: IC4.11 (RB3), IC9.4 (Q)
COMP-REG-CLK: IC8.6 (Q3), U$140.2 (IN)
D0: IC3.23 (D0), IC4.38 (RD0)
D1: IC3.25 (D1), IC4.39 (RD1)
D2: IC3.26 (D2), IC4.40 (RD2)
D3: IC3.27 (D3), IC4.41 (RD3)
D4: IC3.29 (D4), IC4.2 (RD4)
D5: IC3.30 (D5), IC4.3 (RD5)
D6: IC3.31 (D6), IC4.4 (RD6)
D7: IC3.32 (D7), IC4.5 (RD7)
D8: IC3.1 (D8), IC4.25 (RE0)
D9: IC3.2 (D9), IC4.26 (RE1)
GND: C1.P$1, C2.1, C3.P$1, C4.P$1, C5.P$1, C6.P$1, C7.P$1, C8.P$1, C9.P$1, C10.P$1, C11.P$1, C12.P$1, C13.P$1, C14.1, C15.1, C16.1, C17.1, C18.1, C19.P$1, C21.P$1, C22.P$1, C23.P$1, C24.P$1, C25.P$1, C26.P$1, C27.P$1, C28.P$1, C29.P$1, C30.P$1, C31.P$1, C32.P$1, C33.P$1, C34.P$1, C35.P$1, C36.P$1, C37.P$1, C38.P$1, IC1.7 (VSS), IC2.5 (VEE), IC3.9 (GND), IC3.24 (GND), IC3.28 (GND), IC4.6 (VSS), IC4.29 (VSS), IC6.5 (GND), IC7.2 (GND), IC7.4 (GND), IC7.5 (GND), IC7.6 (GND), IC8.7 (GND), IC8.10 (GND), IC9.3 (GND), IC10.1 (GND), IC11.1 (GND), IC12.1 (GND), IC13.4 (GND), J1.BOTTOM_GND (SHIELD), J1.GND@1 (SHIELD), J1.GND@2 (SHIELD), J1.GND@3 (SHIELD), J1.GND@4 (SHIELD), J1.GND@5 (SHIELD), J1.GND@6 (SHIELD), J1.GND@7 (SHIELD), J1.GND@8 (SHIELD), J1.GND@14 (SHIELD), J1.GND@15 (SHIELD), J1.GND@16 (SHIELD), J1.GND@17 (SHIELD), J1.GND_PAD1 (SHIELD), J1.GND_PAD2 (SHIELD), J1.P$1 (SHIELD), J1.P$2 (SHIELD), J2.3 (VSS), J3.BOTTOM_GND (SHIELD), J3.GND@1 (SHIELD), J3.GND@2 (SHIELD), J3.GND@3 (SHIELD), J3.GND@4 (SHIELD), J3.GND@5 (SHIELD), J3.GND@6 (SHIELD), J3.GND@7 (SHIELD), J3.GND@8 (SHIELD), J3.GND@14 (SHIELD), J3.GND@15 (SHIELD), J3.GND@16 (SHIELD), J3.GND@17 (SHIELD), J3.GND_PAD1 (SHIELD), J3.GND_PAD2 (SHIELD), J3.P$1 (SHIELD), J3.P$2 (SHIELD), J4.BOTTOM_GND (SHIELD), J4.GND@1 (SHIELD), J4.GND@2 (SHIELD), J4.GND@3 (SHIELD), J4.GND@4 (SHIELD), J4.GND@5 (SHIELD), J4.GND@6 (SHIELD), J4.GND@7 (SHIELD), J4.GND@8 (SHIELD), J4.GND@14 (SHIELD), J4.GND@15 (SHIELD), J4.GND@16 (SHIELD), J4.GND@17 (SHIELD), J4.GND_PAD1 (SHIELD), J4.GND_PAD2 (SHIELD), J4.P$1 (SHIELD), J4.P$2 (SHIELD), J5.P$2 (2), J6.P$2 (2), J7.P$2 (2), R4.P$2, R5.P$2, R7.P$2, R8.1, R9.1, R10.1, R11.1, R12.P$1, R16.P$1, R23.P$2, R24.P$2, U$1.1 (VP_T), U$1.15 (GND), U$36.3 (GND), U$54.2, U$88.C, U$140.3 (GND), X1.2 (GND)
ICSPCLK: IC4.16 (ICSPCLK/RB6), J2.5 (ICSPCLK)
ICSPDAT: IC4.17 (ICSPDAT/RB7), J2.4 (ICSPDAT)
INPUT: J1.CENTER@1 (CENTER), J1.P$3 (CENTER), U$1.2 (VP)
LE_N: IC3.21 (Q), U$1.6 (!LE!)
LE_P1: IC3.20 (/Q), U$1.7 (LE)
unnamed: R31.P$1, U$36.4 (OUT)
unnamed: R1.P$1, U$1.14 (HYS)
unnamed: IC2.2 (D), R3.P$2, R5.P$1, U$1.11 (Q)
unnamed: IC2.3 (!D!), R2.P$2, R4.P$1, U$1.10 (!Q!)
unnamed: C2.2, R6.P$2, R7.P$1, U$1.8 (VTT)
unnamed: IC3.16 (/EN), R11.2
unnamed: IC3.12 (SETMAX), R10.2
unnamed: IC3.11 (SETMIN), R9.2
unnamed: IC3.10 (LEN), R8.2
unnamed: IC3.4 (IN), IC6.2 (Q), R21.P$2, R23.P$1
unnamed: IC2.7 (Q), R32.P$1
unnamed: IC8.11 (Q4), R18.P$1
unnamed: IC9.2 (CLK), U$140.4 (OUT)
unnamed: C20.P$2, IC5.3 (+), R12.P$2, R13.P$1, R14.P$2
unnamed: C20.P$1, IC5.6 (OUT), R14.P$1, R15.P$2
unnamed: IC3.5 (/IN), IC6.3 (!Q!), R22.P$2, R24.P$1
unnamed: IC8.8 (CLK0), R31.P$2
unnamed: IC4.30 (RA7), X1.3 (OUT)
unnamed: IC4.42 (RC4), R33.P$1
unnamed: R33.P$2, U$88.A
unnamed: IC9.1 (D), R32.P$2
unnamed: IC3.3 (D10), R16.P$2
unnamed: IC6.7 (D), R18.P$2
unnamed: IC8.14 (Q7), R28.1
unnamed: IC8.13 (Q6), R27.1
unnamed: IC8.5 (Q2), R25.1
unnamed: IC8.4 (Q1), R20.1
unnamed: IC8.3 (Q0), R19.1
unnamed: IC4.44 (RC6), R29.P$1
unnamed: IC4.1 (RC7), R30.P$1
RX: R30.P$2, U$54.3
SAMPLE-CLOCK: IC4.32 (RC0), IC8.9 (CLK1)
TRIGGER: J3.CENTER@1 (CENTER), J3.P$3 (CENTER), U$36.2 (IN)
TX: R29.P$2, U$54.1
V2.048: C4.P$2, IC1.6 (VREF), IC7.7 (OUT), IC7.8 (FB), P7.P$1, R13.P$2
VCC2: C8.P$2, C22.P$2, C23.P$2, C24.P$2, C36.P$2, C37.P$2, C38.P$2, IC4.7 (VDD), IC4.28 (VDD), IC9.5 (VCC), IC11.2 (OUT), IC11.4 (OUT), J2.2 (VDD), P6.P$1, R17.P$1, U$36.5 (VCC), U$140.5 (VCC), X1.4 (VCC)
VDAC: C5.P$2, IC1.8 (VOUT), IC5.2 (-), P2.P$1
VIN3.3: C7.P$2, C9.P$2, IC10.3 (IN), IC11.3 (IN), J7.P$1 (1)
VIN+5: C13.P$2, IC13.1 (IN), J6.P$1 (1)
VIN-5: C11.P$2, IC12.4 (IN), J5.P$1 (1)
VREF: C1.P$2, P1.P$1, R15.P$1, U$1.3 (VN), U$1.4 (VN_T)
VREF-!CS!: IC1.2 (!CS!), IC4.8 (RB0)
VREF-SCK: IC1.3 (SCK), IC4.9 (RB1)
VREF-SDI: IC1.4 (SDI), IC4.10 (RB2)

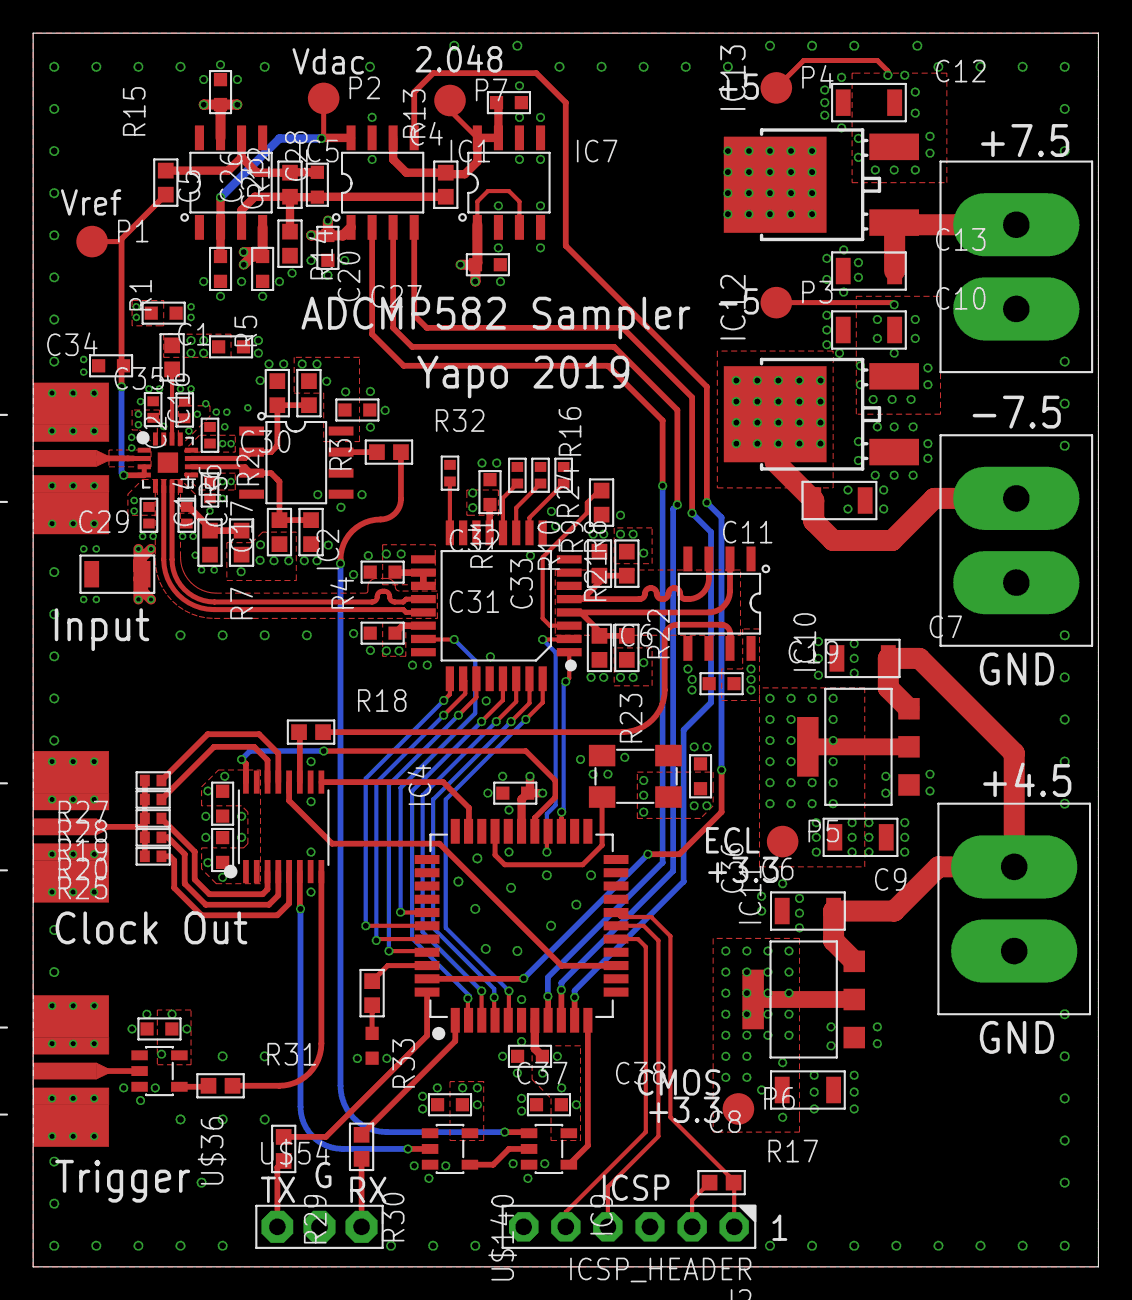
[picture p15: board proto1.brd from above]

Board: 4 copper layers, 64.3 x 74.4 mm, 103 parts (0 on the bottom side), 70 nets.
