tedyapo/sampling-scope-WIP/proto2/proto2.brd

## EAGLE design proto2/proto2.brd (2019-10-04)

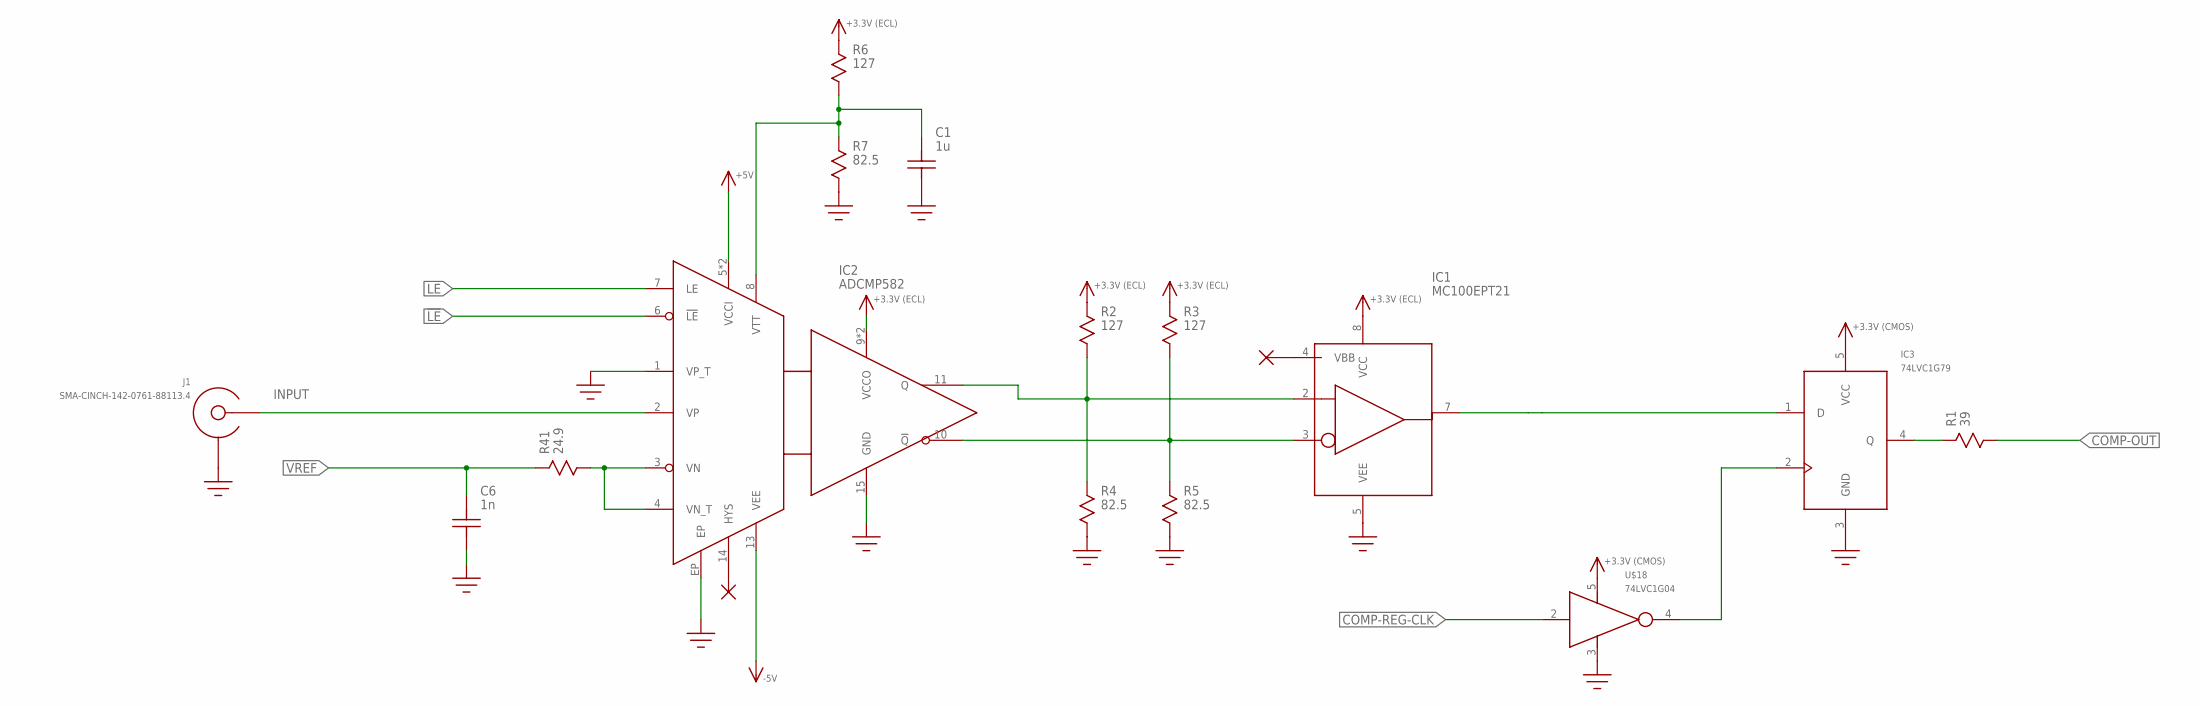
[picture p16: schematic proto2.sch, sheet 1, Front End]

Parts:
C1: 1u; C0402
C6: 1n; C0402
IC1: MC100EPT21; SOIC8
IC2: ADCMP582; TQFN16-EP
IC3: 74LVC1G79; SOT23-5
J1: SMA-CINCH-142-0761-88113.4; SMA-CINCH-142-0761-881-13.4
R1: 39; R0603
R2, R3, R6: 127; R0603
R4, R5, R7: 82.5; R0603
R41: 24.9; 0402
U$18: 74LVC1G04; SOT23-5

Connections:
!LE!: IC2.6 (!LE!); also elsewhere on the board
+5V: IC2.5 (VCCI), IC2.16 (VCCI); also elsewhere on the board
-5V: IC2.13 (VEE); also elsewhere on the board
COMP-OUT: R1.P$2; also elsewhere on the board
COMP-REG-CLK: U$18.2 (IN); also elsewhere on the board
GND: C1.1, C6.1, IC1.5 (VEE), IC2.1 (VP_T), IC2.15 (GND), IC2.EP, IC3.3 (GND), J1.GND@1 (SHIELD), J1.GND@2 (SHIELD), J1.GND@3 (SHIELD), J1.HOLE@1 (SHIELD), J1.HOLE@2 (SHIELD), J1.HOLE@3 (SHIELD), J1.HOLE@4 (SHIELD), J1.VIA@1 (SHIELD), J1.VIA@2 (SHIELD), J1.VIA@3 (SHIELD), J1.VIA@4 (SHIELD), J1.VIA@5 (SHIELD), J1.VIA@6 (SHIELD), R4.P$2, R5.P$2, R7.P$2, U$18.3 (GND); also elsewhere on the board
INPUT: IC2.2 (VP), J1.CENTER
LE: IC2.7 (LE); also elsewhere on the board
unnamed: C1.2, IC2.8 (VTT), R6.P$2, R7.P$1
unnamed: IC1.3 (!D!), IC2.10 (!Q!), R3.P$2, R5.P$1
unnamed: IC1.2 (D), IC2.11 (Q), R2.P$2, R4.P$1
unnamed: IC1.7 (Q), IC3.1 (D)
unnamed: IC3.4 (Q), R1.P$1
unnamed: IC3.2 (CLK), U$18.4 (OUT)
unnamed: IC2.3 (VN), IC2.4 (VN_T), R41.2
VCC1: IC1.8 (VCC), IC2.9 (VCCO), IC2.12 (VCCO), R2.P$1, R3.P$1, R6.P$1; also elsewhere on the board
VCC2: IC3.5 (VCC), U$18.5 (VCC); also elsewhere on the board
VREF: C6.2, R41.1; also elsewhere on the board

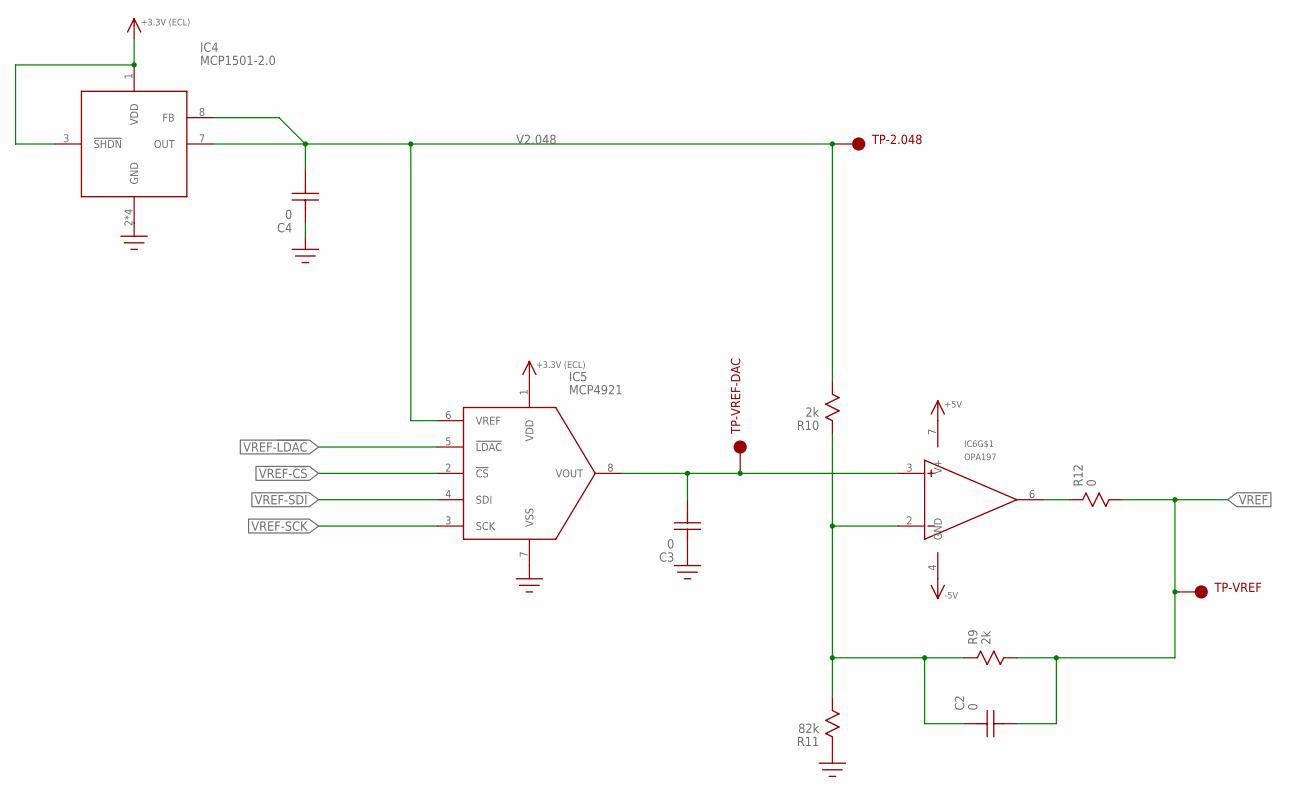
[picture p17: schematic proto2.sch, sheet 2, Reference Voltage Generator]

Parts:
C2, C3, C4: 0; C0603
IC4: MCP1501-2.0; SOIC8
IC5: MCP4921; SOIC8
IC6: OPA197; SOIC8
R9, R10: 2k; R0603
R11: 82k; R0603
R12: 0; R0603
TP-2.048: ICSP_PAD
TP-VREF: ICSP_PAD
TP-VREF-DAC: ICSP_PAD

Connections:
+5V: IC6.7 (V+); also elsewhere on the board
-5V: IC6.4 (GND); also elsewhere on the board
GND: C3.P$2, C4.P$2, IC4.2 (GND), IC4.4 (GND), IC4.5 (GND), IC4.6 (GND), IC5.7 (VSS), R11.P$1; also elsewhere on the board
unnamed: C2.P$2, IC6.2 (-), R9.P$1, R10.P$1, R11.P$2
unnamed: IC6.6 (OUT), R12.P$1
unnamed: C3.P$1, IC5.8 (VOUT), IC6.3 (+), TP-VREF-DAC.P$1
V2.048: C4.P$1, IC4.7 (OUT), IC4.8 (FB), IC5.6 (VREF), R10.P$2, TP-2.048.P$1
VCC1: IC4.1 (VDD), IC4.3 (!SHDN!), IC5.1 (VDD); also elsewhere on the board
VREF: C2.P$1, R9.P$2, R12.P$2, TP-VREF.P$1; also elsewhere on the board
VREF-!CS!: IC5.2 (!CS!); also elsewhere on the board
VREF-!LDAC!: IC5.5 (!LDAC!); also elsewhere on the board
VREF-SCK: IC5.3 (SCK); also elsewhere on the board
VREF-SDI: IC5.4 (SDI); also elsewhere on the board

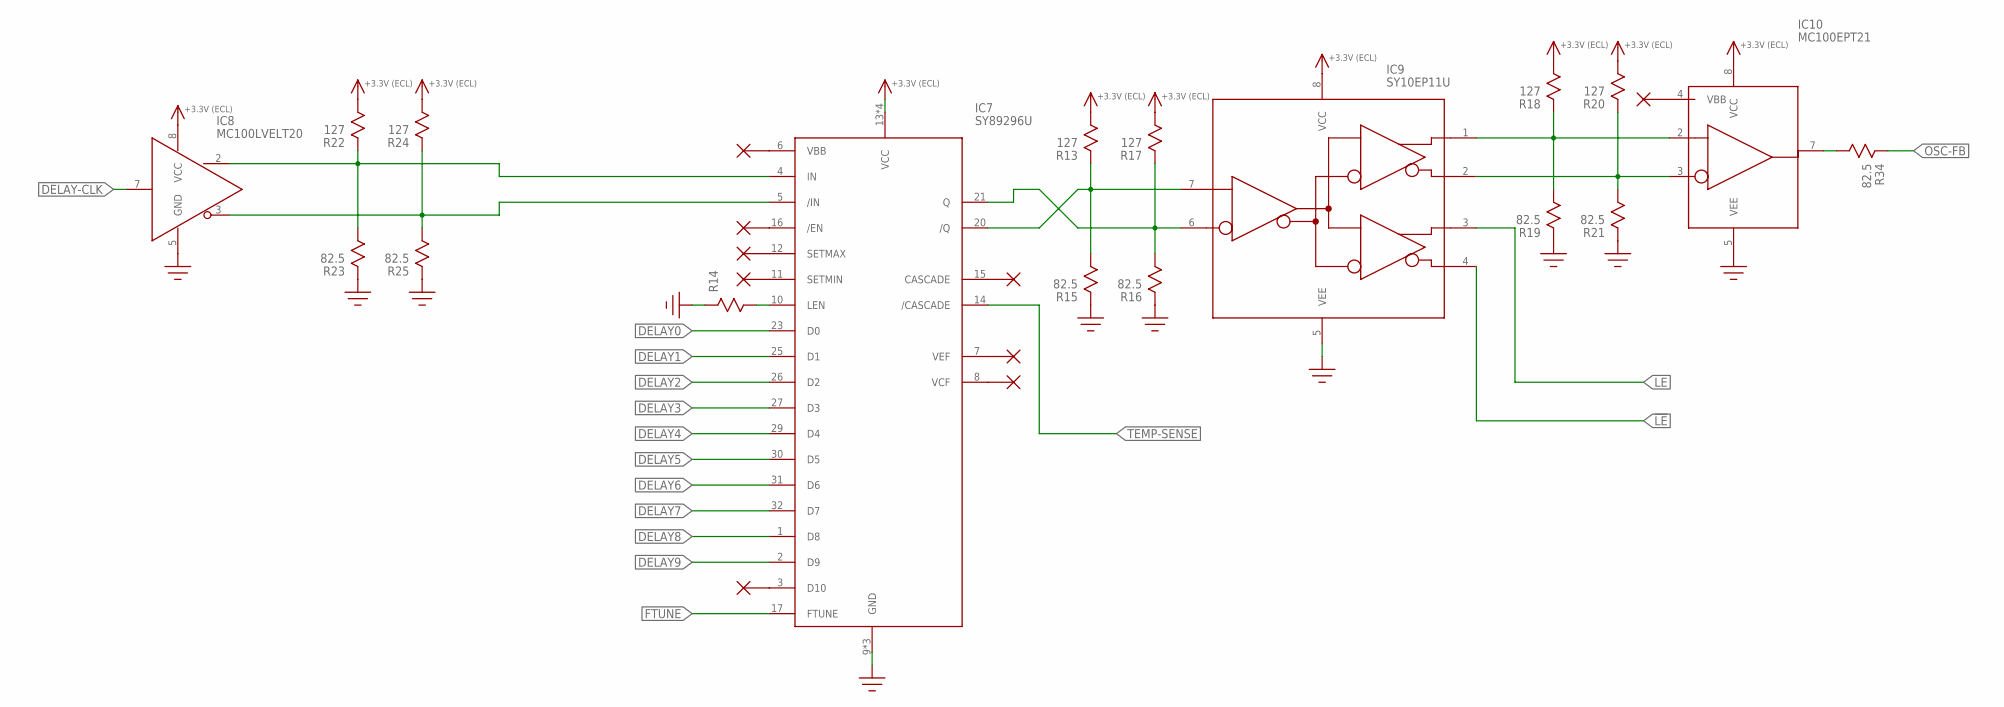
[picture p18: schematic proto2.sch, sheet 3, Delay Line]

Parts:
IC7: SY89296U; TQFP32_7X7
IC8: MC100LVELT20; SOIC8
IC9: SY10EP11U; SOIC8
IC10: MC100EPT21; SOIC8
R13, R17, R18, R20, R22, R24: 127; R0603
R14: R0603
R15, R16, R19, R21, R23, R25, R34: 82.5; R0603

Connections:
!LE!: IC9.4 (!Q1!); also elsewhere on the board
DELAY0: IC7.23 (D0); also elsewhere on the board
DELAY1: IC7.25 (D1); also elsewhere on the board
DELAY2: IC7.26 (D2); also elsewhere on the board
DELAY3: IC7.27 (D3); also elsewhere on the board
DELAY4: IC7.29 (D4); also elsewhere on the board
DELAY5: IC7.30 (D5); also elsewhere on the board
DELAY6: IC7.31 (D6); also elsewhere on the board
DELAY7: IC7.32 (D7); also elsewhere on the board
DELAY8: IC7.1 (D8); also elsewhere on the board
DELAY9: IC7.2 (D9); also elsewhere on the board
DELAY-!IN!: IC7.5 (/IN), IC8.3 (!Q!), R24.P$1, R25.P$2
DELAY-CLK: IC8.7 (D); also elsewhere on the board
DELAY-IN: IC7.4 (IN), IC8.2 (Q), R22.P$1, R23.P$2
FTUNE: IC7.17 (FTUNE); also elsewhere on the board
GND: IC7.9 (GND), IC7.24 (GND), IC7.28 (GND), IC8.5 (GND), IC9.5 (VEE), IC10.5 (VEE), R14.P$1, R15.P$1, R16.P$1, R19.P$1, R21.P$1, R23.P$1, R25.P$1; also elsewhere on the board
LE: IC9.3 (Q1); also elsewhere on the board
unnamed: IC7.10 (LEN), R14.P$2
unnamed: IC10.7 (Q), R34.P$2
unnamed: IC7.20 (/Q), IC9.7 (D), R13.P$1, R15.P$2
unnamed: IC9.1 (Q0), IC10.2 (D), R18.P$1, R19.P$2
unnamed: IC7.21 (Q), IC9.6 (!D!), R16.P$2, R17.P$1
unnamed: IC9.2 (!Q0!), IC10.3 (!D!), R20.P$1, R21.P$2
OSC-FB: R34.P$1; also elsewhere on the board
TEMP-SENSE: IC7.14 (/CASCADE); also elsewhere on the board
VCC1: IC7.13 (VCC), IC7.18 (VCC), IC7.19 (VCC), IC7.22 (VCC), IC8.8 (VCC), IC9.8 (VCC), IC10.8 (VCC), R13.P$2, R17.P$2, R18.P$2, R20.P$2, R22.P$2, R24.P$2; also elsewhere on the board

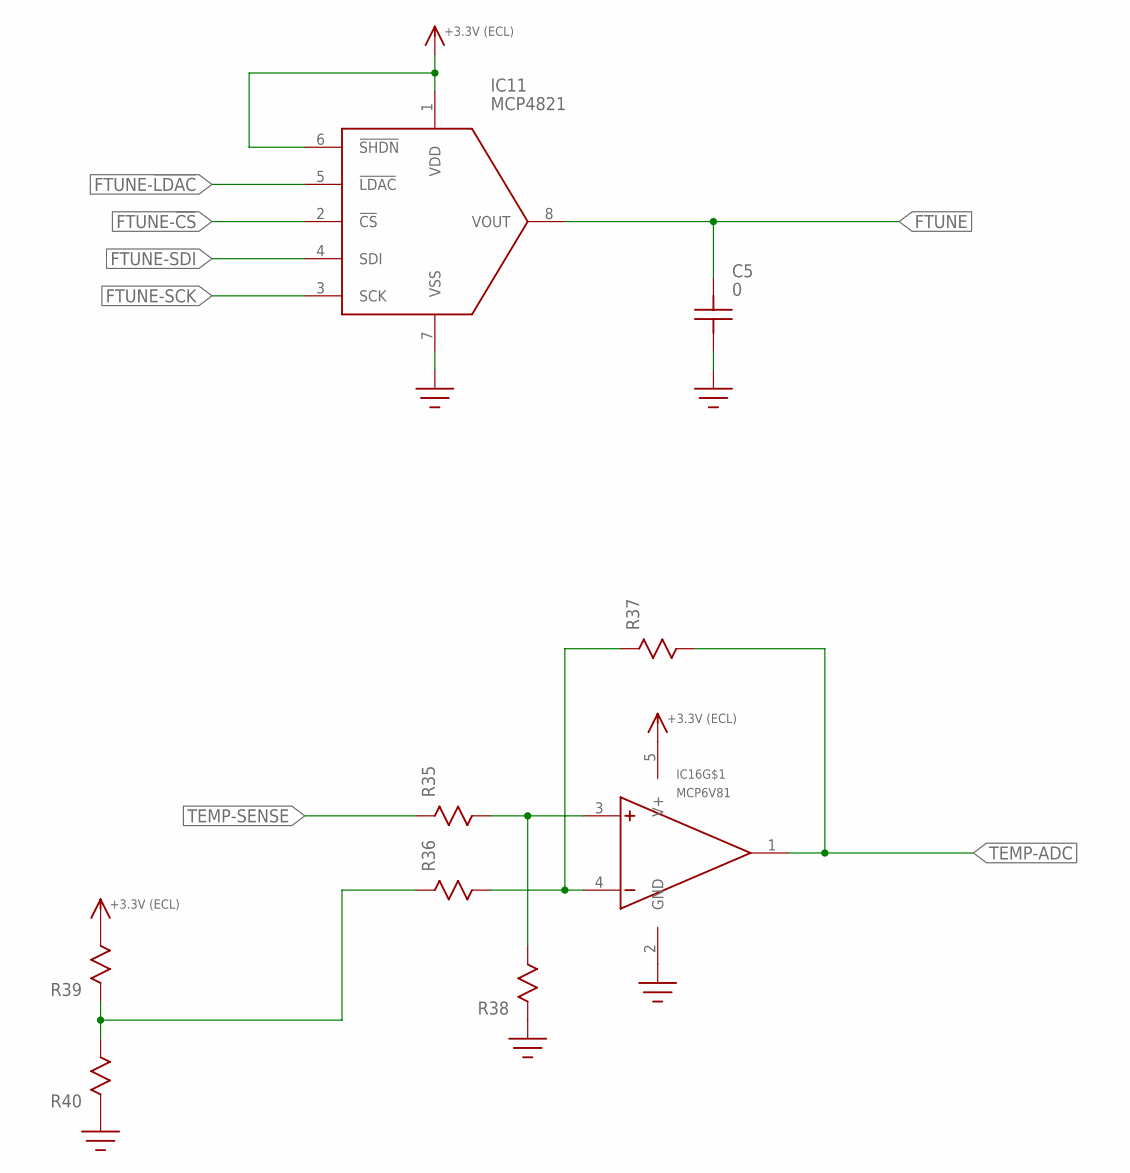
[picture p19: schematic proto2.sch, sheet 4, Delay Tune]

Parts:
C5: 0; C0603
IC11: MCP4821; SOIC8
IC16: MCP6V81; SOT23-5
R35, R36, R37, R38, R39, R40: R0603

Connections:
FTUNE: C5.P$2, IC11.8 (VOUT); also elsewhere on the board
FTUNE-!CS!: IC11.2 (!CS!); also elsewhere on the board
FTUNE-!LDAC!: IC11.5 (!LDAC!); also elsewhere on the board
FTUNE-SCK: IC11.3 (SCK); also elsewhere on the board
FTUNE-SDI: IC11.4 (SDI); also elsewhere on the board
GND: C5.P$1, IC11.7 (VSS), IC16.2 (GND), R38.P$1, R40.P$1; also elsewhere on the board
unnamed: IC16.3 (+), R35.P$2, R38.P$2
unnamed: IC16.4 (-), R36.P$2, R37.P$1
unnamed: R36.P$1, R39.P$1, R40.P$2
TEMP-ADC: IC16.1 (OUT), R37.P$2; also elsewhere on the board
TEMP-SENSE: R35.P$1; also elsewhere on the board
VCC1: IC11.1 (VDD), IC11.6 (!SHDN!), IC16.5 (V+), R39.P$2; also elsewhere on the board

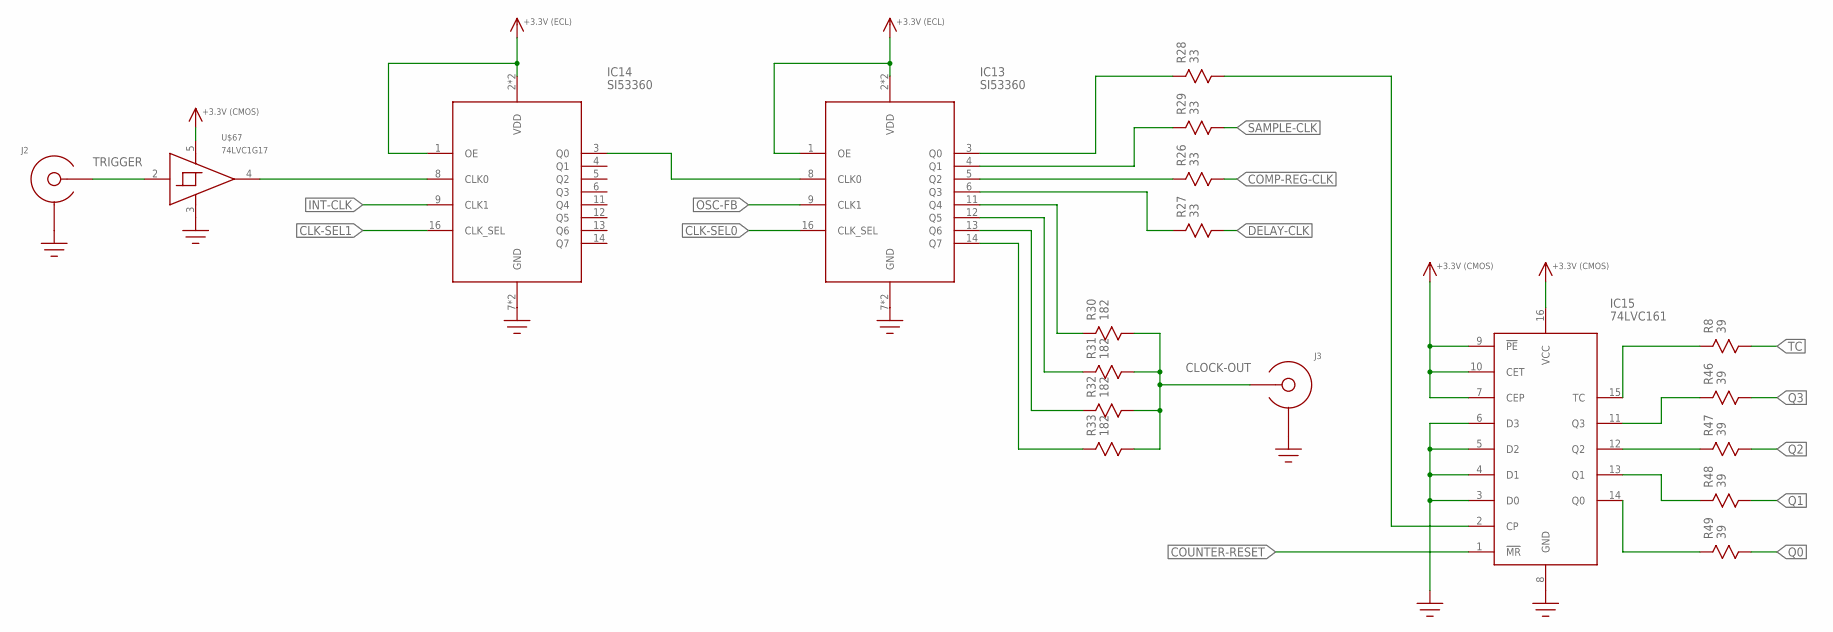
[picture p20: schematic proto2.sch, sheet 5, Clock Distribution]

Parts:
IC13, IC14: SI53360; TSSOP16
IC15: 74LVC161; SOIC-16
J2, J3: SMA-EDGE-LAUNCH4L-4020-TAPER-FIXED; SMA_EDGE_LAUNCH_4L_4020_TAPER_FIXED
R8, R46, R47, R48, R49: 39; 0402
R26, R27, R28, R29: 33; R0603
R30, R31, R32, R33: 182; R0603
U$67: 74LVC1G17; SOT23-5

Connections:
CLK-SEL0: IC13.16 (CLK_SEL); also elsewhere on the board
CLK-SEL1: IC14.16 (CLK_SEL); also elsewhere on the board
CLOCK-OUT: J3.CENTER@1 (CENTER), J3.P$3 (CENTER), R30.P$2, R31.P$2, R32.P$2, R33.P$2
COMP-REG-CLK: R26.P$2; also elsewhere on the board
COUNTER-RESET: IC15.1 (!MR!); also elsewhere on the board
DELAY-CLK: R27.P$2; also elsewhere on the board
GND: IC13.7 (GND), IC13.10 (GND), IC14.7 (GND), IC14.10 (GND), IC15.3 (D0), IC15.4 (D1), IC15.5 (D2), IC15.6 (D3), IC15.8 (GND), J2.BOTTOM_GND (SHIELD), J2.GND@1 (SHIELD), J2.GND@2 (SHIELD), J2.GND@3 (SHIELD), J2.GND@4 (SHIELD), J2.GND@5 (SHIELD), J2.GND@6 (SHIELD), J2.GND@7 (SHIELD), J2.GND@8 (SHIELD), J2.GND@14 (SHIELD), J2.GND@15 (SHIELD), J2.GND@16 (SHIELD), J2.GND@17 (SHIELD), J2.GND_PAD1 (SHIELD), J2.GND_PAD2 (SHIELD), J2.P$1 (SHIELD), J2.P$2 (SHIELD), J3.BOTTOM_GND (SHIELD), J3.GND@1 (SHIELD), J3.GND@2 (SHIELD), J3.GND@3 (SHIELD), J3.GND@4 (SHIELD), J3.GND@5 (SHIELD), J3.GND@6 (SHIELD), J3.GND@7 (SHIELD), J3.GND@8 (SHIELD), J3.GND@14 (SHIELD), J3.GND@15 (SHIELD), J3.GND@16 (SHIELD), J3.GND@17 (SHIELD), J3.GND_PAD1 (SHIELD), J3.GND_PAD2 (SHIELD), J3.P$1 (SHIELD), J3.P$2 (SHIELD), U$67.3 (GND); also elsewhere on the board
INT-CLK: IC14.9 (CLK1); also elsewhere on the board
unnamed: IC15.12 (Q2), R47.1
unnamed: IC13.5 (Q2), R26.P$1
unnamed: IC13.6 (Q3), R27.P$1
unnamed: IC13.4 (Q1), R29.P$1
unnamed: IC14.8 (CLK0), U$67.4 (OUT)
unnamed: IC13.8 (CLK0), IC14.3 (Q0)
unnamed: IC13.3 (Q0), R28.P$1
unnamed: IC15.2 (CP), R28.P$2
unnamed: IC13.11 (Q4), R30.P$1
unnamed: IC13.12 (Q5), R31.P$1
unnamed: IC13.13 (Q6), R32.P$1
unnamed: IC13.14 (Q7), R33.P$1
unnamed: IC15.11 (Q3), R46.1
unnamed: IC15.15 (TC), R8.1
unnamed: IC15.13 (Q1), R48.1
unnamed: IC15.14 (Q0), R49.1
OSC-FB: IC13.9 (CLK1); also elsewhere on the board
Q0: R49.2; also elsewhere on the board
Q1: R48.2; also elsewhere on the board
Q2: R47.2; also elsewhere on the board
Q3: R46.2; also elsewhere on the board
SAMPLE-CLK: R29.P$2; also elsewhere on the board
TC: R8.2; also elsewhere on the board
TRIGGER: J2.CENTER@1 (CENTER), J2.P$3 (CENTER), U$67.2 (IN)
VCC1: IC13.1 (OE), IC13.2 (VDD), IC13.15 (VDD), IC14.1 (OE), IC14.2 (VDD), IC14.15 (VDD); also elsewhere on the board
VCC2: IC15.7 (CEP), IC15.9 (!PE!), IC15.10 (CET), IC15.16 (VCC), U$67.5 (VCC); also elsewhere on the board
