tedyapo/sampling-scope-WIP/proto2/proto2.brd

## EAGLE design proto2/proto2.brd (continued)

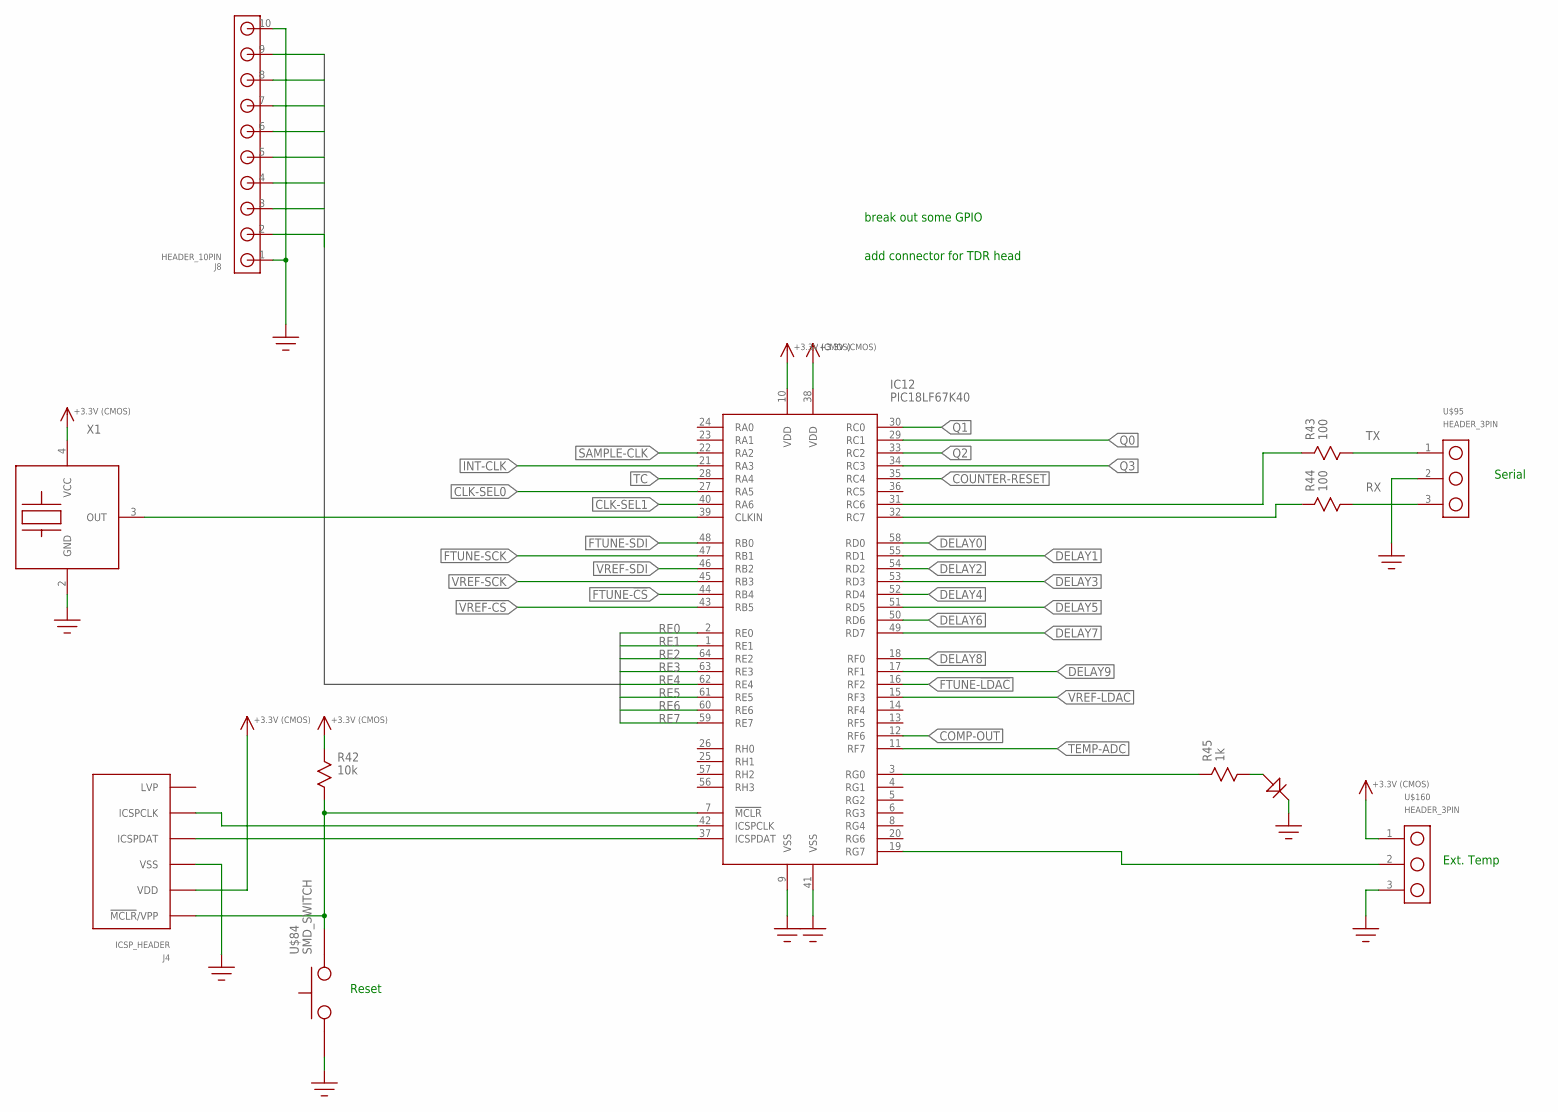
[picture p21: schematic proto2.sch, sheet 6, Microcontroller]

Parts:
IC12: PIC18LF67K40; TQFP-100-10X10
J4: ICSP_HEADER; HEADER_6PIN
J8: HEADER_10PIN
R42: 10k; R0603
R43, R44: 100; R0603
R45: 1k; R0603
U$84: SMD_SWITCH
U$95, U$160: HEADER_3PIN
U$97: LED_0603
X1: XTAL_OSC; XTAL_3.2X5

Connections:
CLK-SEL0: IC12.27 (RA5); also elsewhere on the board
CLK-SEL1: IC12.40 (RA6); also elsewhere on the board
COMP-OUT: IC12.12 (RF6); also elsewhere on the board
COUNTER-RESET: IC12.35 (RC4); also elsewhere on the board
DELAY0: IC12.58 (RD0); also elsewhere on the board
DELAY1: IC12.55 (RD1); also elsewhere on the board
DELAY2: IC12.54 (RD2); also elsewhere on the board
DELAY3: IC12.53 (RD3); also elsewhere on the board
DELAY4: IC12.52 (RD4); also elsewhere on the board
DELAY5: IC12.51 (RD5); also elsewhere on the board
DELAY6: IC12.50 (RD6); also elsewhere on the board
DELAY7: IC12.49 (RD7); also elsewhere on the board
DELAY8: IC12.18 (RF0); also elsewhere on the board
DELAY9: IC12.17 (RF1); also elsewhere on the board
FTUNE-!CS!: IC12.44 (RB4); also elsewhere on the board
FTUNE-!LDAC!: IC12.16 (RF2); also elsewhere on the board
FTUNE-SCK: IC12.47 (RB1); also elsewhere on the board
FTUNE-SDI: IC12.48 (RB0); also elsewhere on the board
GND: IC12.9 (VSS), IC12.41 (VSS), J4.3 (VSS), J8.1, J8.10, U$84.P$1, U$84.P$2, U$95.2, U$97.C, U$160.3, X1.2 (GND); also elsewhere on the board
INT-CLK: IC12.21 (RA3); also elsewhere on the board
unnamed: IC12.7 (!MCLR!), J4.1 (!MCLR!/VPP), R42.P$2, U$84.P$3, U$84.P$4
unnamed: IC12.37 (ICSPDAT), J4.4 (ICSPDAT)
unnamed: IC12.42 (ICSPCLK), J4.5 (ICSPCLK)
unnamed: R45.P$2, U$97.A
unnamed: IC12.39 (CLKIN), X1.3 (OUT)
unnamed: IC12.32 (RC7), R44.P$1
unnamed: IC12.31 (RC6), R43.P$1
unnamed: IC12.3 (RG0), R45.P$1
unnamed: IC12.19 (RG7), U$160.2
Q0: IC12.29 (RC1); also elsewhere on the board
Q1: IC12.30 (RC0); also elsewhere on the board
Q2: IC12.33 (RC2); also elsewhere on the board
Q3: IC12.34 (RC3); also elsewhere on the board
RE0: IC12.2 (RE0), J8.9
RE1: IC12.1 (RE1), J8.8
RE2: IC12.64 (RE2), J8.7
RE3: IC12.63 (RE3), J8.6
RE4: IC12.62 (RE4), J8.5
RE5: IC12.61 (RE5), J8.4
RE6: IC12.60 (RE6), J8.3
RE7: IC12.59 (RE7), J8.2
RX: R44.P$2, U$95.3
SAMPLE-CLK: IC12.22 (RA2); also elsewhere on the board
TC: IC12.28 (RA4); also elsewhere on the board
TEMP-ADC: IC12.11 (RF7); also elsewhere on the board
TX: R43.P$2, U$95.1
VCC2: IC12.10 (VDD), IC12.38 (VDD), J4.2 (VDD), R42.P$1, U$160.1, X1.4 (VCC); also elsewhere on the board
VREF-!CS!: IC12.43 (RB5); also elsewhere on the board
VREF-!LDAC!: IC12.15 (RF3); also elsewhere on the board
VREF-SCK: IC12.45 (RB3); also elsewhere on the board
VREF-SDI: IC12.46 (RB2); also elsewhere on the board

Notes on the sheet:
break out some GPIO
add connector for TDR head
Serial
Ext. Temp
Reset

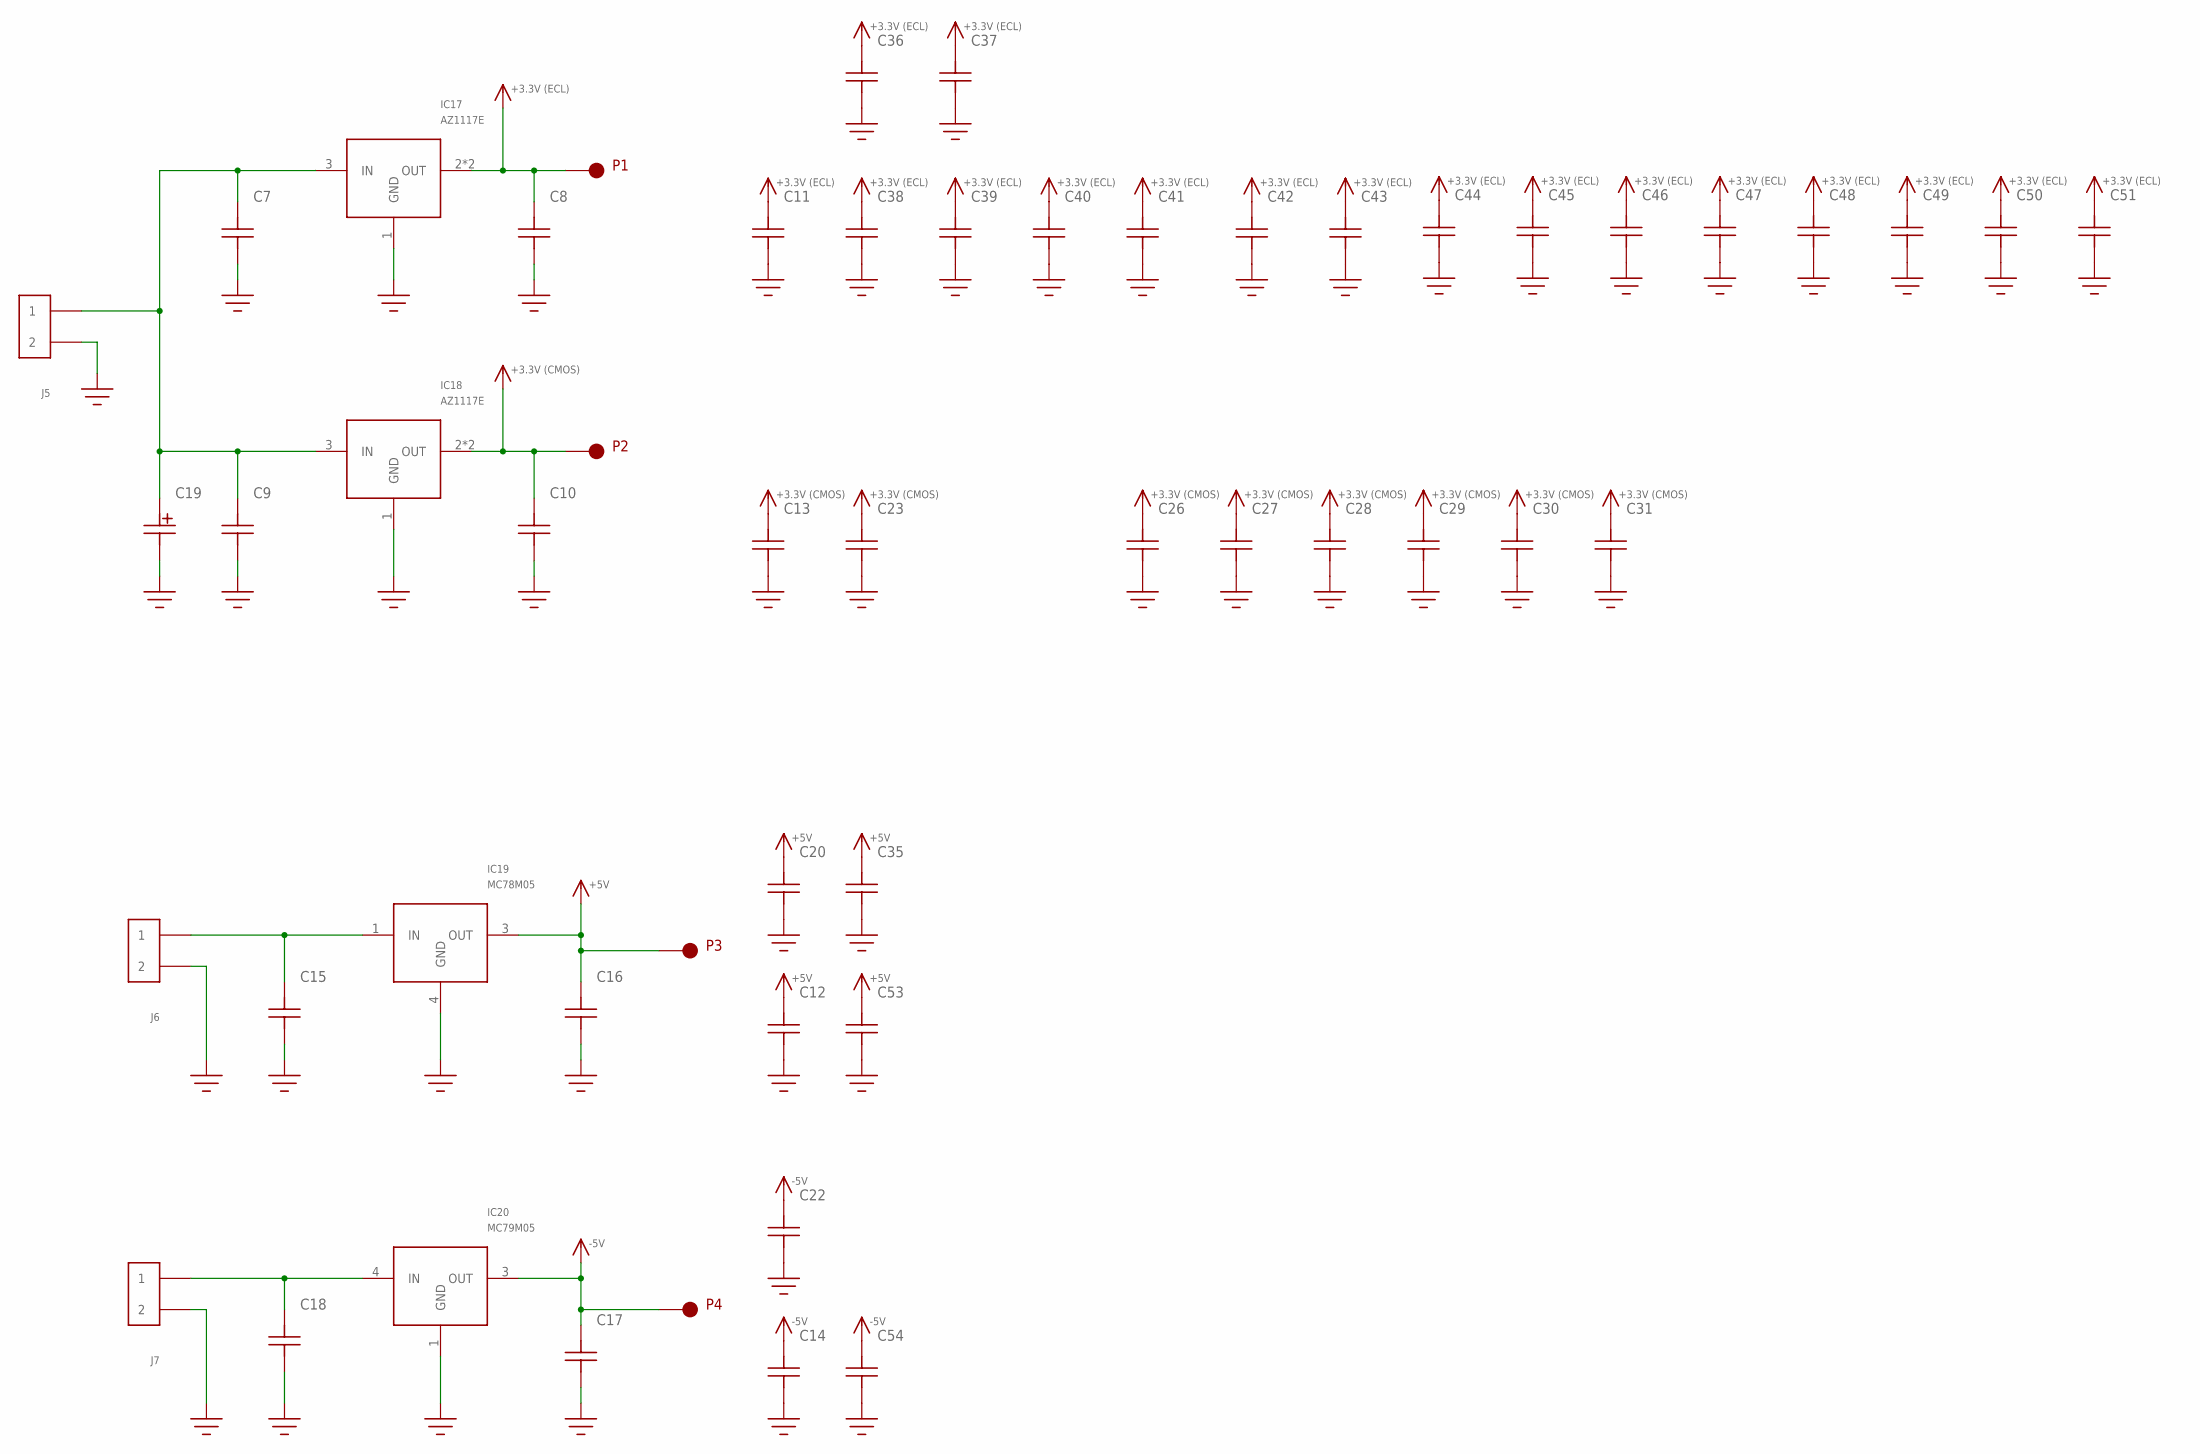
[picture p22: schematic proto2.sch, sheet 7, Power]

Parts:
C7, C8, C9, C10, C15, C16, C17, C18: C1206; 1206
C11, C12, C13, C14, C23, C26, C27, C28, C29, C30, C31, C38, C39, C40, C41, C42, C43, C44, C45, C46, C47, C48, C49, C50, C51, C53, C54: C0603
C19: C-POLARIZED; CAP-E61
C20, C22, C35, C36, C37: C; C0402
IC17, IC18: AZ1117E; SOT-223
IC19: MC78M05; DPAK
IC20: MC79M05; DPAK
J5, J6, J7: HEADER_2PINSCREW-TERM; FCI_20020316_SCREW_TERM_2P
P1, P2, P3, P4: ICSP_PAD

Connections:
+5V: C12.P$2, C16.P$2, C20.2, C35.2, C53.P$2, IC19.3 (OUT), P3.P$1; also elsewhere on the board
-5V: C14.P$2, C17.P$2, C22.2, C54.P$2, IC20.3 (OUT), P4.P$1; also elsewhere on the board
GND: C7.P$1, C8.P$1, C9.P$1, C10.P$1, C11.P$1, C12.P$1, C13.P$1, C14.P$1, C15.P$1, C16.P$1, C17.P$1, C18.P$1, C19.-, C20.1, C22.1, C23.P$1, C26.P$1, C27.P$1, C28.P$1, C29.P$1, C30.P$1, C31.P$1, C35.1, C36.1, C37.1, C38.P$1, C39.P$1, C40.P$1, C41.P$1, C42.P$1, C43.P$1, C44.P$1, C45.P$1, C46.P$1, C47.P$1, C48.P$1, C49.P$1, C50.P$1, C51.P$1, C53.P$1, C54.P$1, IC17.1 (GND), IC18.1 (GND), IC19.4 (GND), IC20.1 (GND), J5.P$2 (2), J6.P$2 (2), J7.P$2 (2); also elsewhere on the board
unnamed: C7.P$2, C9.P$2, C19.+, IC17.3 (IN), IC18.3 (IN), J5.P$1 (1)
unnamed: C15.P$2, IC19.1 (IN), J6.P$1 (1)
unnamed: C18.P$2, IC20.4 (IN), J7.P$1 (1)
VCC1: C8.P$2, C11.P$2, C36.2, C37.2, C38.P$2, C39.P$2, C40.P$2, C41.P$2, C42.P$2, C43.P$2, C44.P$2, C45.P$2, C46.P$2, C47.P$2, C48.P$2, C49.P$2, C50.P$2, C51.P$2, IC17.2 (OUT), IC17.4 (OUT), P1.P$1; also elsewhere on the board
VCC2: C10.P$2, C13.P$2, C23.P$2, C26.P$2, C27.P$2, C28.P$2, C29.P$2, C30.P$2, C31.P$2, IC18.2 (OUT), IC18.4 (OUT), P2.P$1; also elsewhere on the board

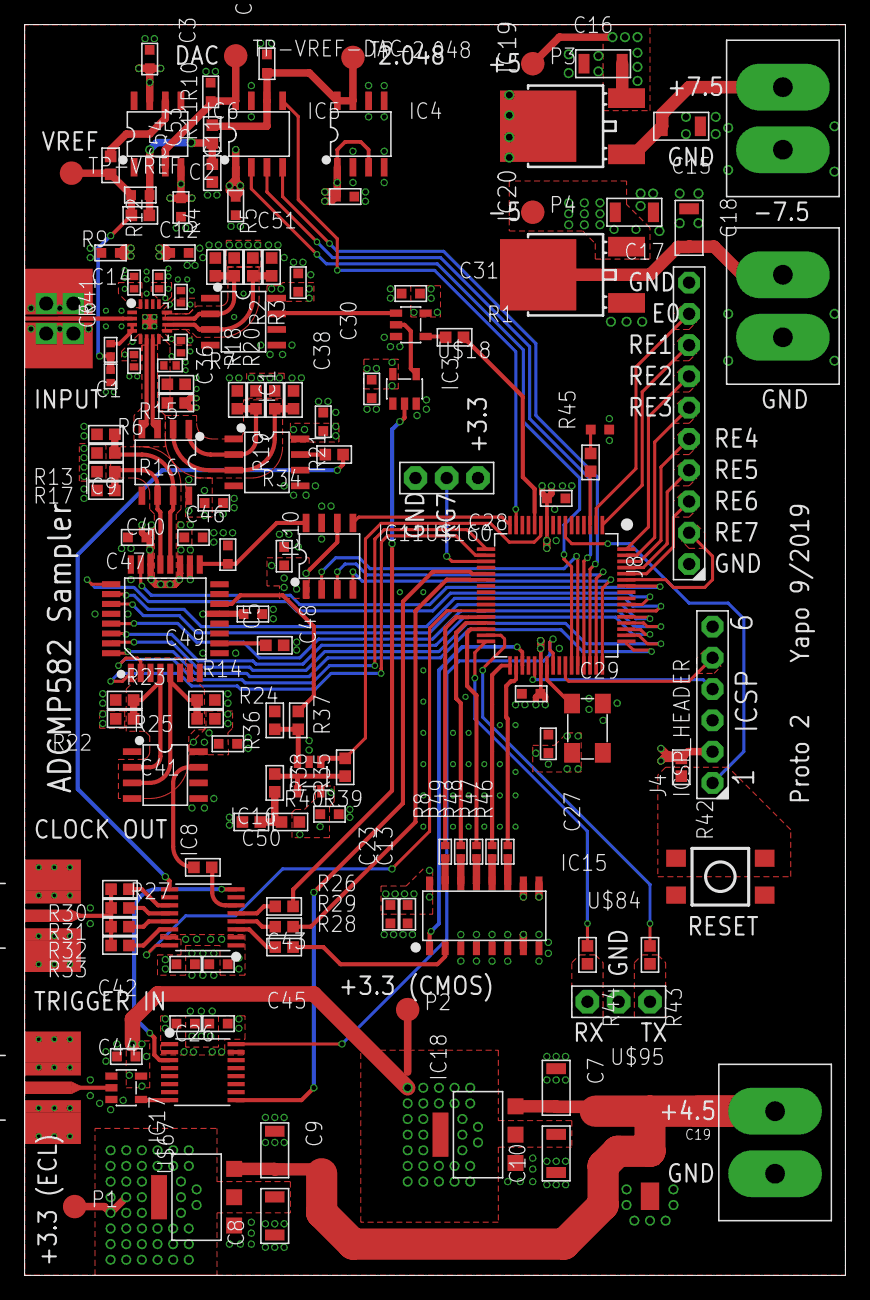
[picture p23: board proto2.brd from above]

Board: 4 copper layers, 66.7 x 101.6 mm, 138 parts (0 on the bottom side), 106 nets.
