tedyapo/sampling-scope-WIP/timebase-cal-proto/calibrator-test.brd

## EAGLE design timebase-cal-proto/calibrator-test.brd (2019-10-04)

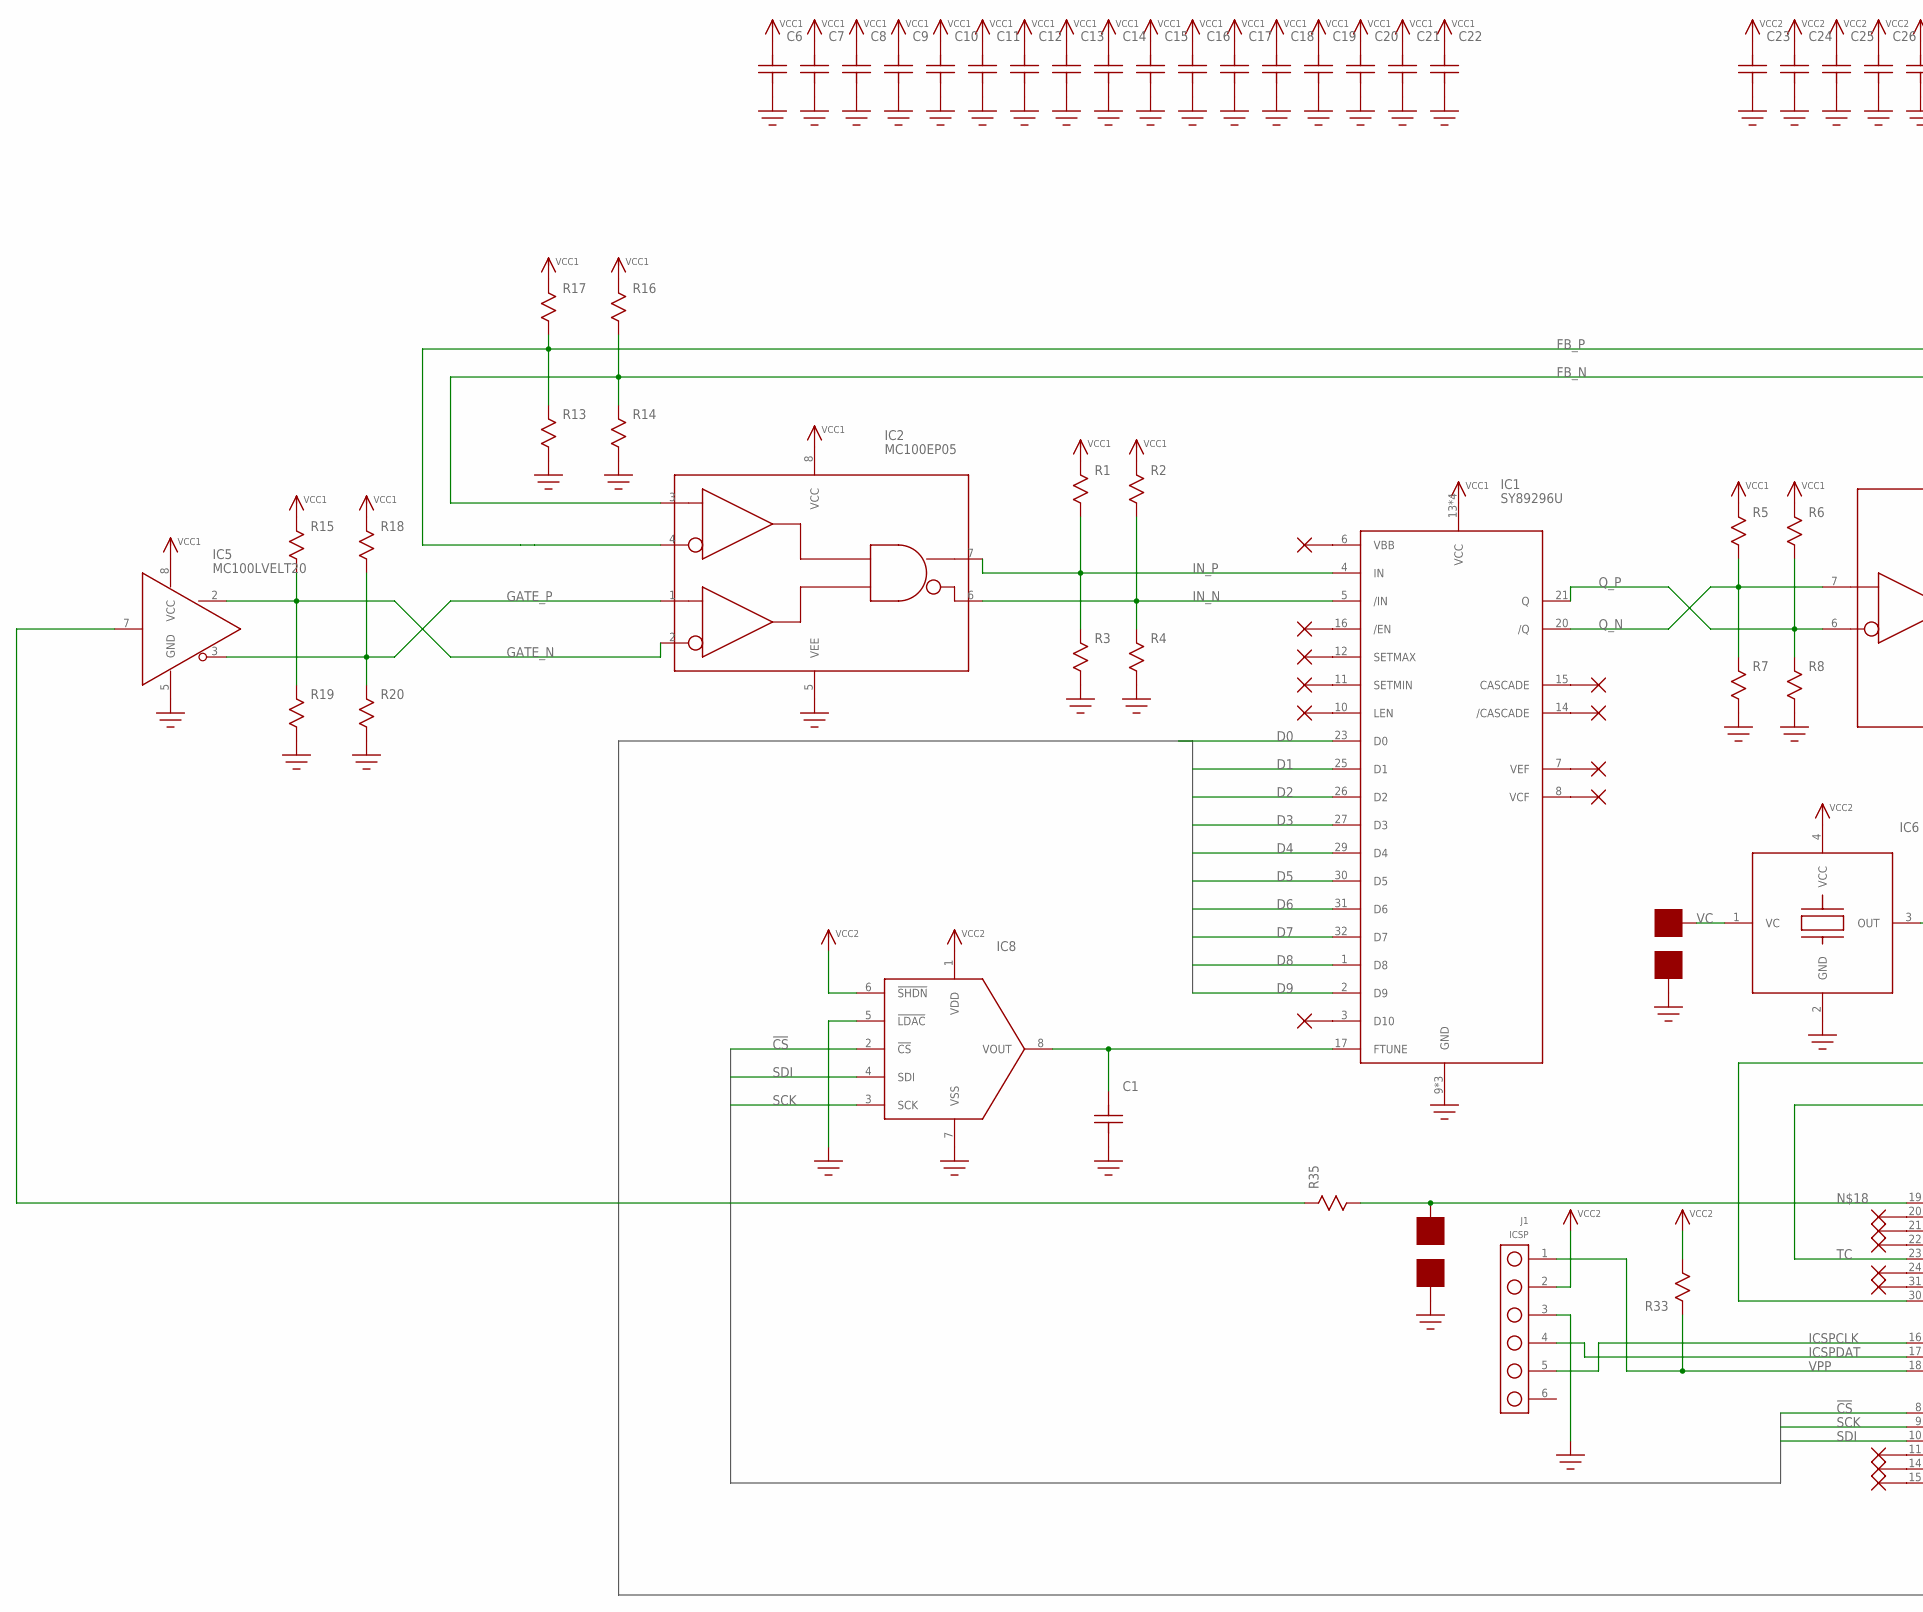
[picture p24: schematic calibrator-test.sch, part in row 1, column 1]

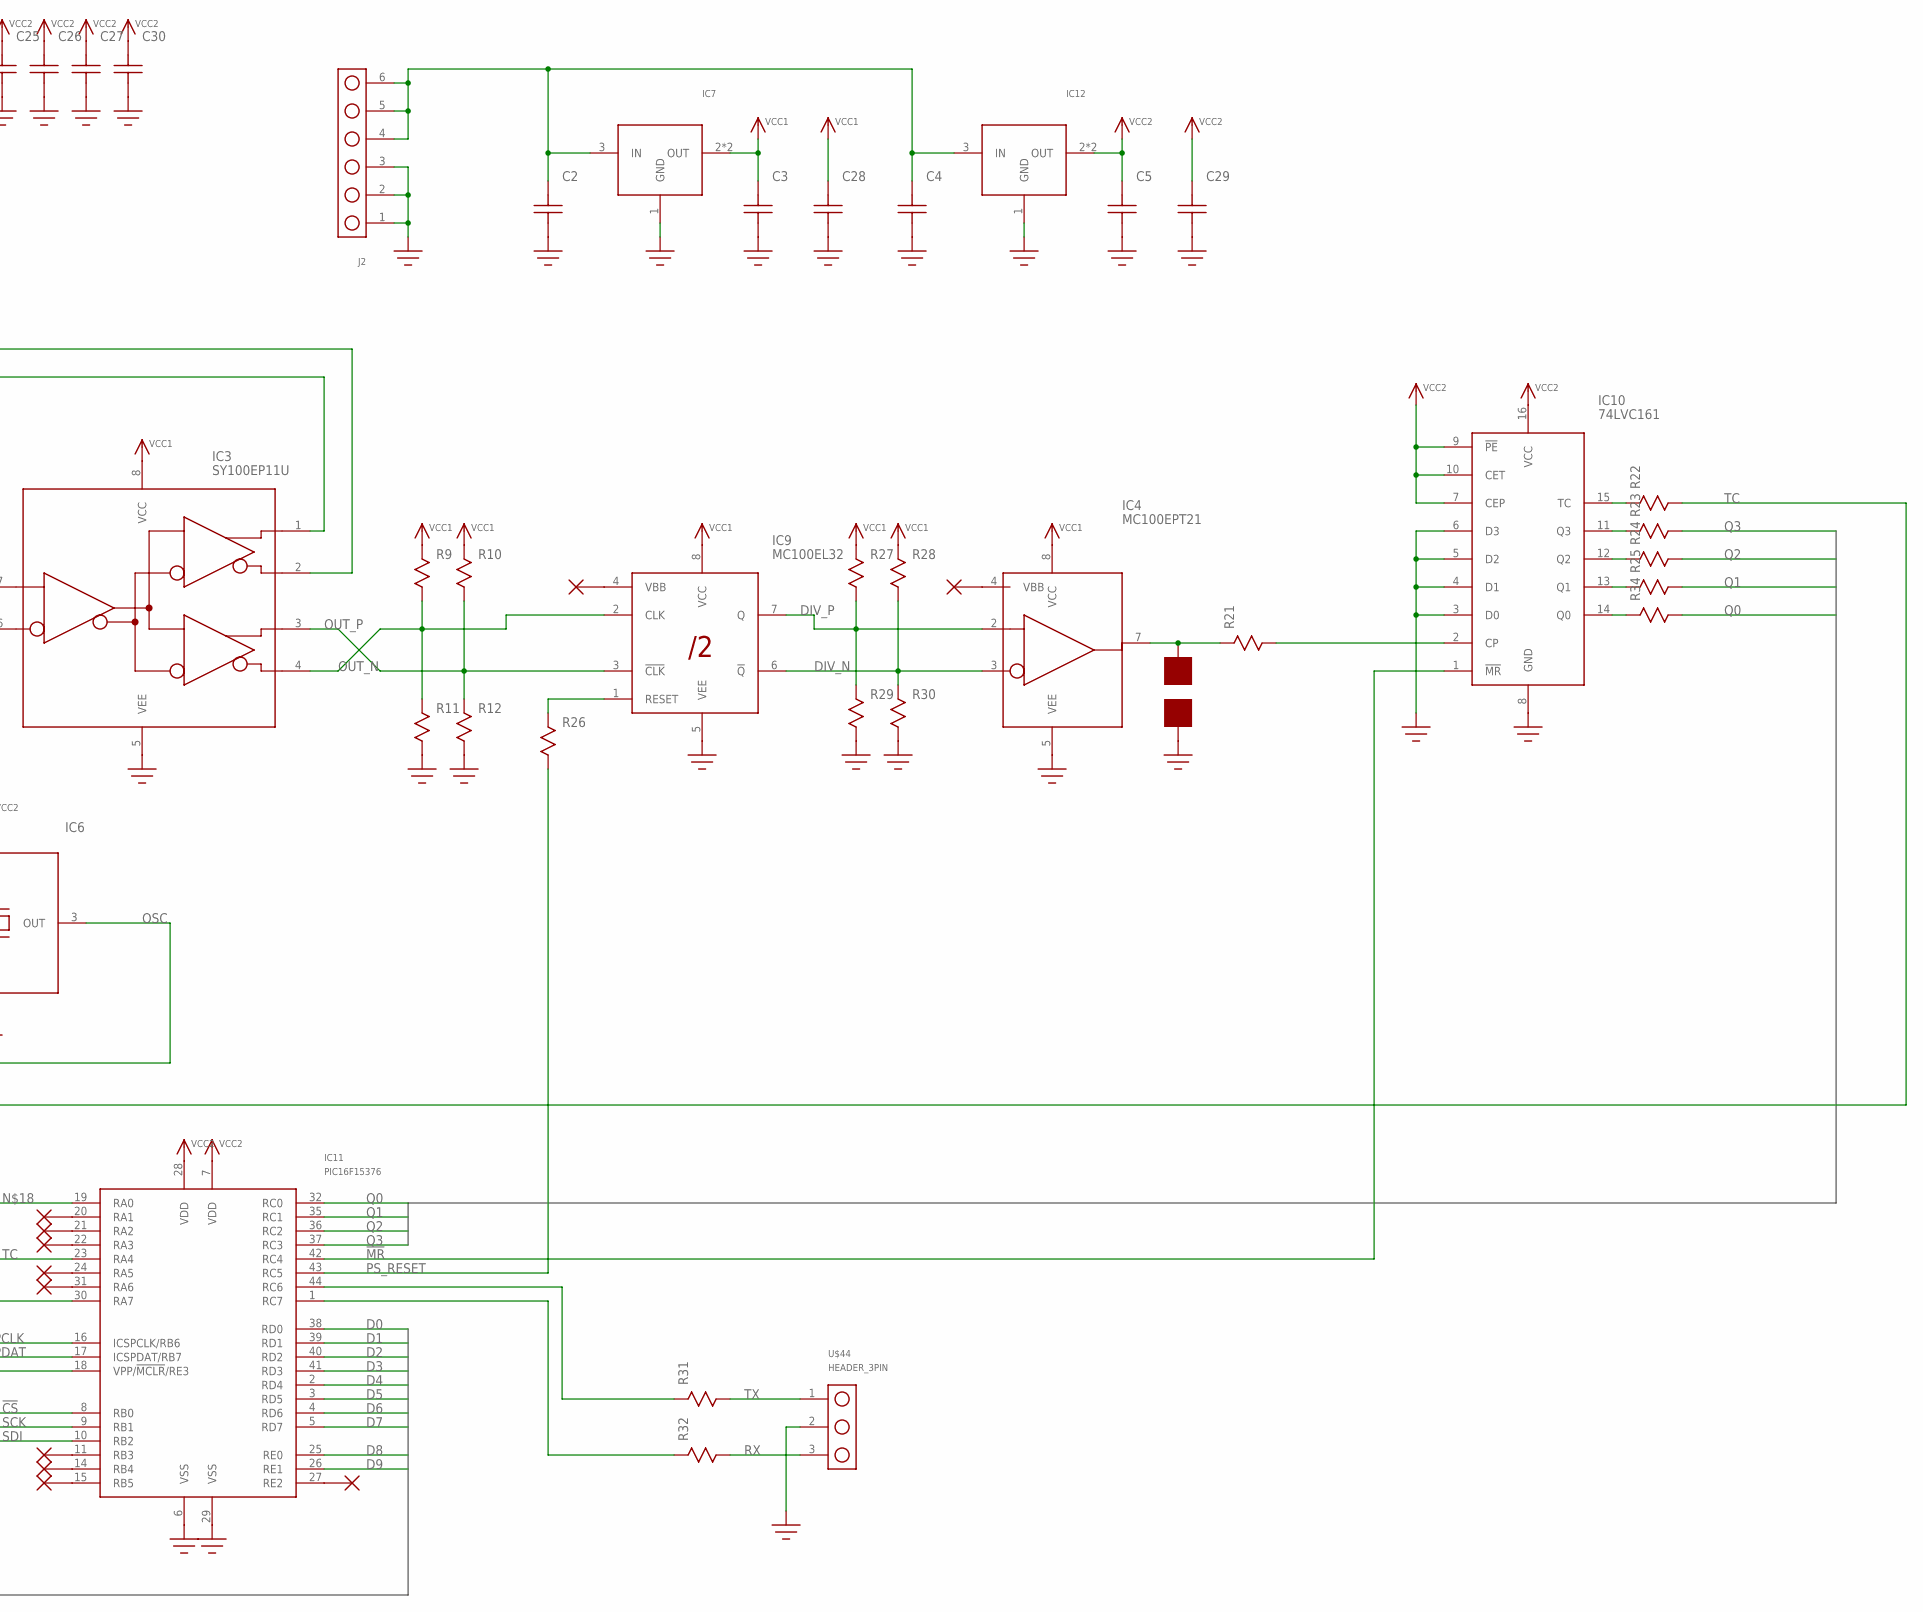
[picture p25: schematic calibrator-test.sch, part in row 1, column 2]

Parts:
C1, C6, C7, C8, C9, C10, C11, C12, C13, C14, C15, C16, C17, C18, C19, C20, C21, C22, C23, C24, C25, C26, C27, C30: C0603
C2, C3, C4, C5, C28, C29: C1206; 1206
IC1: SY89296U; TQFP32_7X7
IC2: MC100EP05; SOIC8
IC3: SY100EP11U; SOIC8
IC4: MC100EPT21; SOIC8
IC5: MC100LVELT20; SOIC8
IC6: XTAL_OSC_VC; XTAL_3.2X5
IC7, IC12: AZ1117E; SOT-223
IC8: MCP48X1; SOIC8
IC9: MC100EL32; SOIC8
IC10: 74LVC161; SOIC-16
IC11: PIC16F15376; TQFP44
J1: ICSP; HEADER_6PIN
J2: HEADER_6PIN
R1, R2, R3, R4, R5, R6, R7, R8, R9, R10, R11, R12, R13, R14, R15, R16, R17, R18, R19, R20, R21, R22, R23, R24, R25, R26, R27, R28, R29, R30, R31, R32, R33, R34, R35: R0603
U$44: HEADER_3PIN
U$48, U$75, U$76, U$77, U$78, U$81: PAD50MIL; PAD_50MIL

Connections:
!CS!: IC8.2 (!CS!), IC11.8 (RB0)
!GATE!: IC5.7 (D), R35.P$1
!MR!: IC10.1 (!MR!), IC11.42 (RC4)
D0: IC1.23 (D0), IC11.38 (RD0)
D1: IC1.25 (D1), IC11.39 (RD1)
D2: IC1.26 (D2), IC11.40 (RD2)
D3: IC1.27 (D3), IC11.41 (RD3)
D4: IC1.29 (D4), IC11.2 (RD4)
D5: IC1.30 (D5), IC11.3 (RD5)
D6: IC1.31 (D6), IC11.4 (RD6)
D7: IC1.32 (D7), IC11.5 (RD7)
D8: IC1.1 (D8), IC11.25 (RE0)
D9: IC1.2 (D9), IC11.26 (RE1)
DIV_N: IC4.3 (!D!), IC9.6 (!Q!), R28.P$2, R30.P$1
DIV_P: IC4.2 (D), IC9.7 (Q), R27.P$2, R29.P$1
FB_N: IC2.3 (D1), IC3.1 (Q0), R14.P$1, R16.P$2
FB_P: IC2.4 (!D1!), IC3.2 (!Q0!), R13.P$1, R17.P$2
GATE_N: IC2.2 (!D0!), IC5.2 (Q), R15.P$2, R19.P$1
GATE_P: IC2.1 (D0), IC5.3 (!Q!), R18.P$2, R20.P$1
GND: C1.P$1, C2.P$1, C3.P$1, C4.P$1, C5.P$1, C6.P$1, C7.P$1, C8.P$1, C9.P$1, C10.P$1, C11.P$1, C12.P$1, C13.P$1, C14.P$1, C15.P$1, C16.P$1, C17.P$1, C18.P$1, C19.P$1, C20.P$1, C21.P$1, C22.P$1, C23.P$1, C24.P$1, C25.P$1, C26.P$1, C27.P$1, C28.P$1, C29.P$1, C30.P$1, IC1.9 (GND), IC1.24 (GND), IC1.28 (GND), IC2.5 (VEE), IC3.5 (VEE), IC4.5 (VEE), IC5.5 (GND), IC6.2 (GND), IC7.1 (GND), IC8.5 (!LDAC!), IC8.7 (VSS), IC9.5 (VEE), IC10.3 (D0), IC10.4 (D1), IC10.5 (D2), IC10.6 (D3), IC10.8 (GND), IC11.6 (VSS), IC11.29 (VSS), IC12.1 (GND), J1.3, J2.1, J2.2, J2.3, R3.P$2, R4.P$2, R7.P$2, R8.P$2, R11.P$2, R12.P$2, R13.P$2, R14.P$2, R19.P$2, R20.P$2, R29.P$2, R30.P$2, U$44.2, U$76.P$1, U$78.P$1, U$81.P$1
ICSPCLK: IC11.16 (ICSPCLK/RB6), J1.5
ICSPDAT: IC11.17 (ICSPDAT/RB7), J1.4
IN_N: IC1.5 (/IN), IC2.6 (!Q!), R2.P$2, R4.P$1
IN_P: IC1.4 (IN), IC2.7 (Q), R1.P$2, R3.P$1
unnamed: IC10.2 (CP), R21.P$2
unnamed: IC10.15 (TC), R22.P$1
unnamed: IC10.11 (Q3), R23.P$1
unnamed: IC10.12 (Q2), R24.P$1
unnamed: IC10.13 (Q1), R25.P$1
unnamed: IC10.14 (Q0), R34.P$1
unnamed: IC11.19 (RA0), R35.P$2, U$75.P$1
unnamed: IC11.44 (RC6), R31.P$1
unnamed: IC11.1 (RC7), R32.P$1
unnamed: C2.P$2, C4.P$2, IC7.3 (IN), IC12.3 (IN), J2.4, J2.5, J2.6
unnamed: C1.P$2, IC1.17 (FTUNE), IC8.8 (VOUT)
unnamed: IC9.1 (RESET), R26.P$1
unnamed: IC4.7 (Q), R21.P$1, U$77.P$1
OSC: IC6.3 (OUT), IC11.30 (RA7)
OUT_N: IC3.4 (!Q1!), IC9.2 (CLK), R9.P$2, R11.P$1
OUT_P: IC3.3 (Q1), IC9.3 (!CLK!), R10.P$2, R12.P$1
PS_RESET: IC11.43 (RC5), R26.P$2
Q0: IC11.32 (RC0), R34.P$2
Q1: IC11.35 (RC1), R25.P$2
Q2: IC11.36 (RC2), R24.P$2
Q3: IC11.37 (RC3), R23.P$2
Q_N: IC1.20 (/Q), IC3.7 (D), R5.P$2, R7.P$1
Q_P: IC1.21 (Q), IC3.6 (!D!), R6.P$2, R8.P$1
RX: R32.P$2, U$44.3
SCK: IC8.3 (SCK), IC11.9 (RB1)
SDI: IC8.4 (SDI), IC11.10 (RB2)
TC: IC11.23 (RA4), R22.P$2
TX: R31.P$2, U$44.1
VC: IC6.1 (VC), U$48.P$1
VCC1: C3.P$2, C6.P$2, C7.P$2, C8.P$2, C9.P$2, C10.P$2, C11.P$2, C12.P$2, C13.P$2, C14.P$2, C15.P$2, C16.P$2, C17.P$2, C18.P$2, C19.P$2, C20.P$2, C21.P$2, C22.P$2, C28.P$2, IC1.13 (VCC), IC1.18 (VCC), IC1.19 (VCC), IC1.22 (VCC), IC2.8 (VCC), IC3.8 (VCC), IC4.8 (VCC), IC5.8 (VCC), IC7.2 (OUT), IC7.4 (OUT), IC9.8 (VCC), R1.P$1, R2.P$1, R5.P$1, R6.P$1, R9.P$1, R10.P$1, R15.P$1, R16.P$1, R17.P$1, R18.P$1, R27.P$1, R28.P$1
VCC2: C5.P$2, C23.P$2, C24.P$2, C25.P$2, C26.P$2, C27.P$2, C29.P$2, C30.P$2, IC6.4 (VCC), IC8.1 (VDD), IC8.6 (!SHDN!), IC10.7 (CEP), IC10.9 (!PE!), IC10.10 (CET), IC10.16 (VCC), IC11.7 (VDD), IC11.28 (VDD), IC12.2 (OUT), IC12.4 (OUT), J1.2, R33.P$2
VPP: IC11.18 (VPP/!MCLR!/RE3), J1.1, R33.P$1

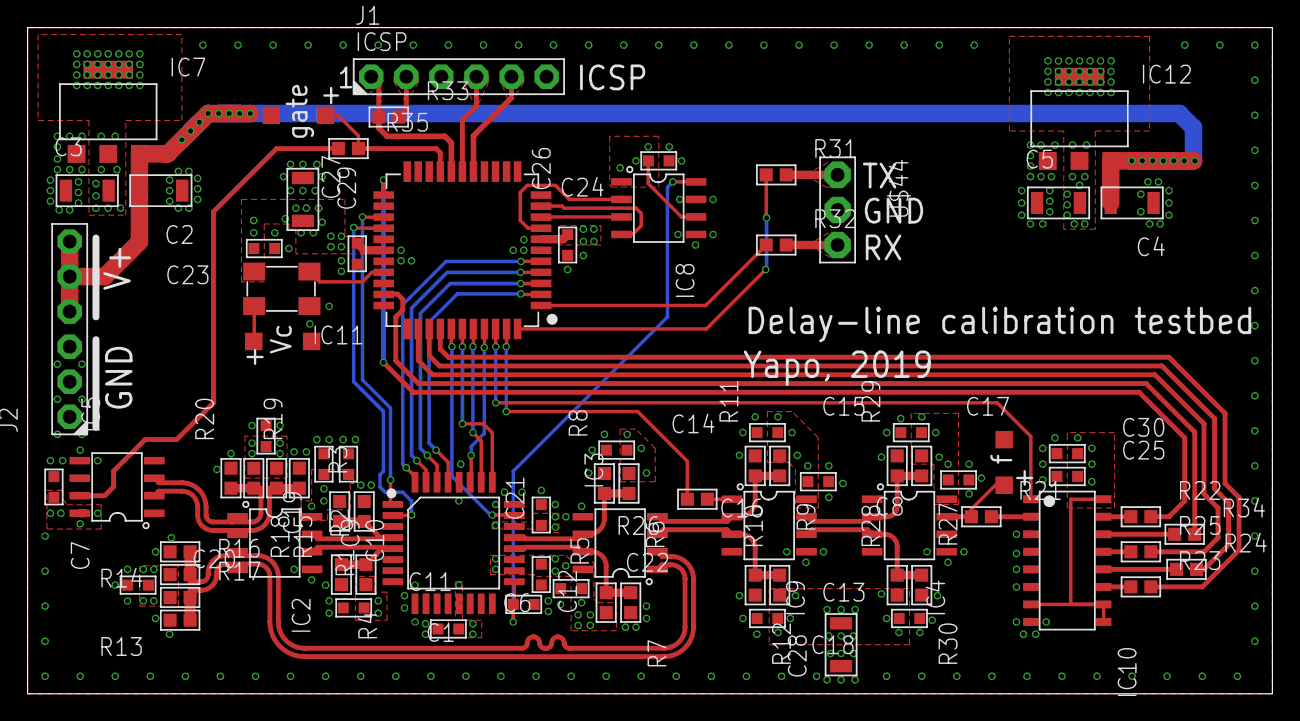
[picture p26: board calibrator-test.brd from above]

Board: 4 copper layers, 90.2 x 48.3 mm, 86 parts (0 on the bottom side), 56 nets.
