tedyapo/sampling-scope-WIP/(commit log)

2019-10-04 initial release
    [calibrator-test.brd, calibrator-test.sch, proto1.brd, proto1.sch, proto2.brd, proto2.sch]
2019-12-12 proto2 schematic PDF properly formatted
